krdarrah/trigBoard_docs/README.md

# trigBoard_docs
Documentation for trigBoard
