krdarrah/trigBoard_docs/docs/ePaperCoronaDisplay.rst

=======================
E-Paper Corona Display
=======================

.. raw:: html

    <div style="text-align: center; margin-bottom: 2em;">
    <iframe width="560" height="315" src="https://www.youtube.com/embed/fxBOs1GMj-A" frameborder="0" allow="accelerometer; autoplay; encrypted-media; gyroscope; picture-in-picture" allowfullscreen></iframe>
    </div>

This is a hard one to keep up to date, so make sure to check the `epaper Corona GIT page for latest <https://github.com/krdarrah/coronaDisplay_trigBoardEpaper>`_
