krdarrah/trigBoard_docs/docs/arduinoIoT.rst

.. _ArduinoIot:

=========================================
Arduino IoT Cloud - Temperature Monitor
=========================================

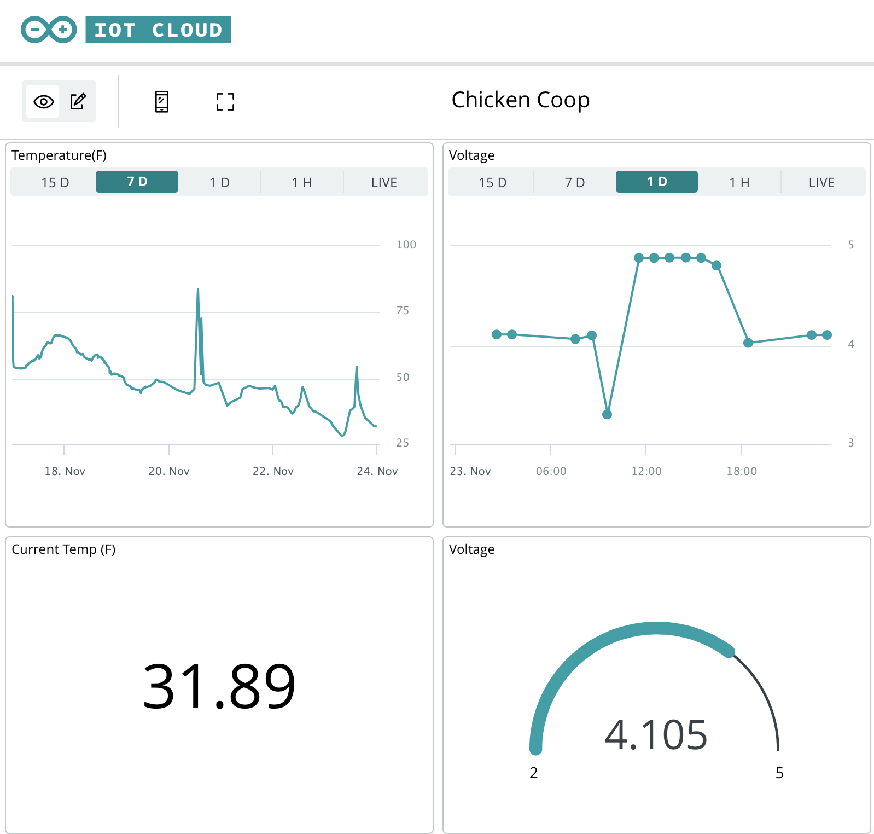
[picture p29: docs/images/arduinoIotDashboard.png]


Looking for a super easy and simple cloud service platform?  This might be a good fit for you!  There is also a free version to get you started, so that's a nice perk as well.

I was also happy to see they have a mobile app you can use to view your dashboards: 

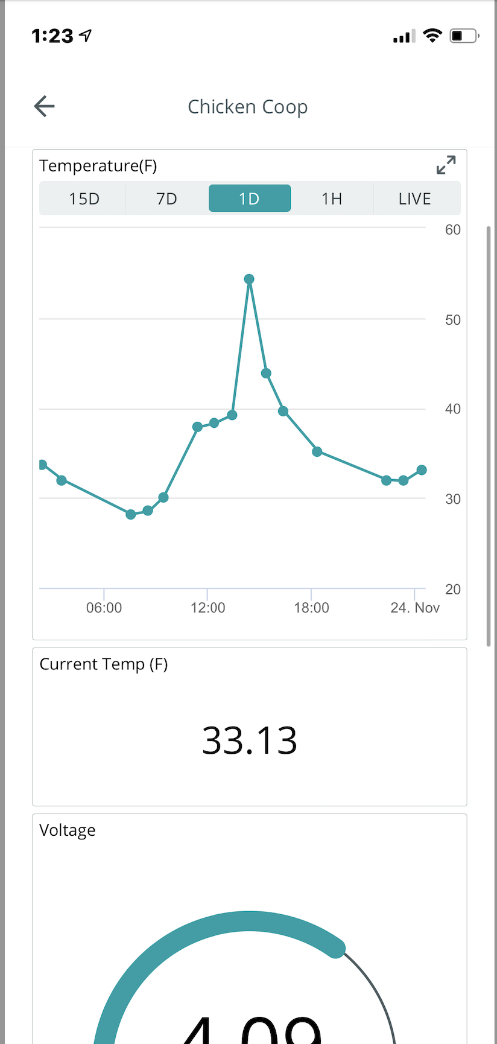
[picture p30: docs/images/mobilearduinocloud.png]


.. note::
	You can setup very easily with this using any ESP32 board, but this tutorial is specific to using the trigBoard and a temperature sensor.  Hopefully, this tutorial will show you how to set this up with any kind of sensor with the trigBoard (or no sensor at all - just contact status)

**Wiring**
-------------

You can use this without 

The wiring is simple - just need an `MCP9808 Breakout Board from Adafruit <https://www.adafruit.com/product/1782>`_ which is a very accurate, fast, and reliable temperature sensor.  Can also get these boards on Amazon for much cheaper.

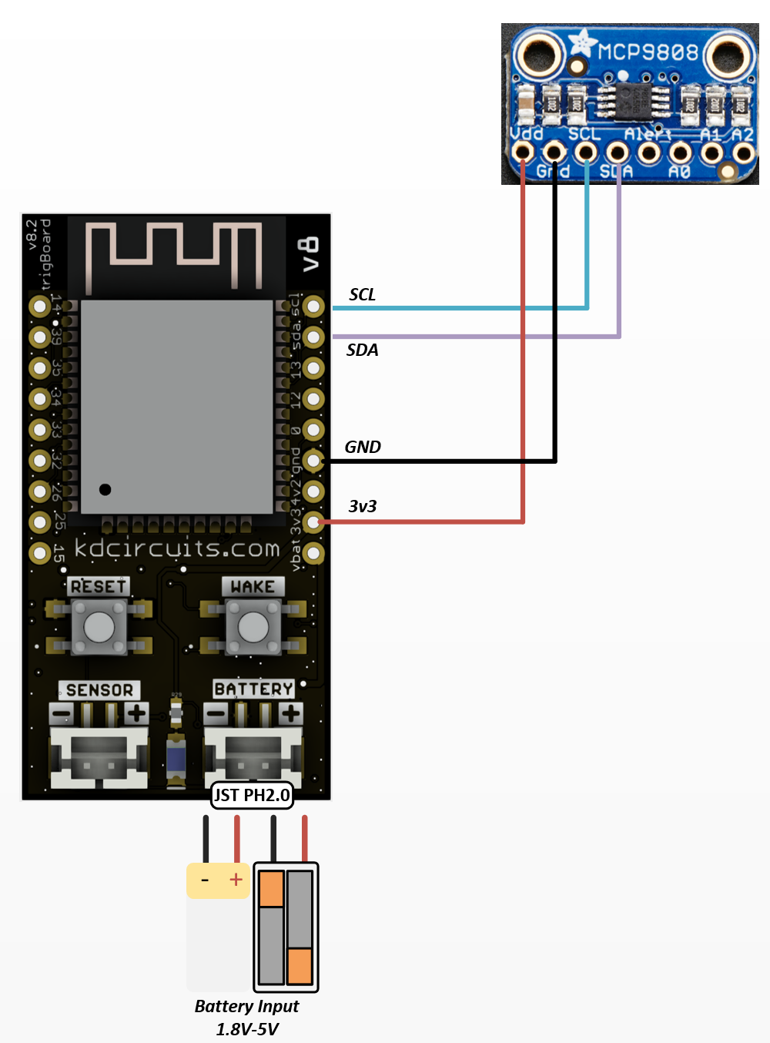
[picture p31: docs/images/MCP9808wiringwithtrigboard.png]


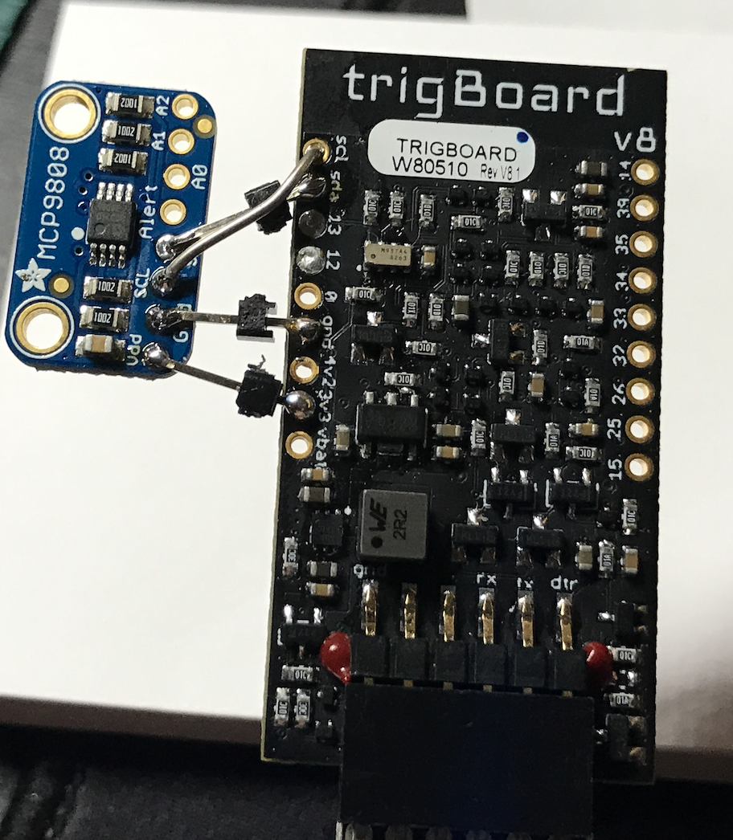
[picture p32: docs/images/MCP9808Installed.png]


Or even cleaner: 

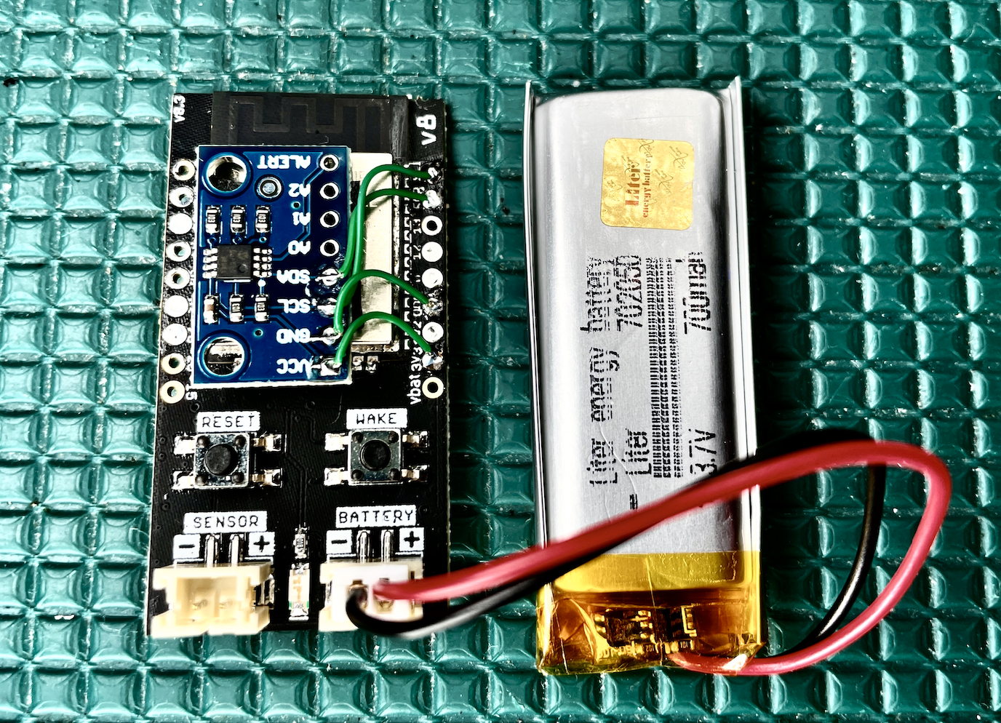
[picture p33: docs/images/mcp9808mountedtoshield.png]


**Arduino IoT Cloud Setup**
---------------------------------

First thing to do is login to your account at `Arduino IoT Cloud <https://create.arduino.cc/iot/>`_

Then let's just get started and create a device - will be a third party board: 

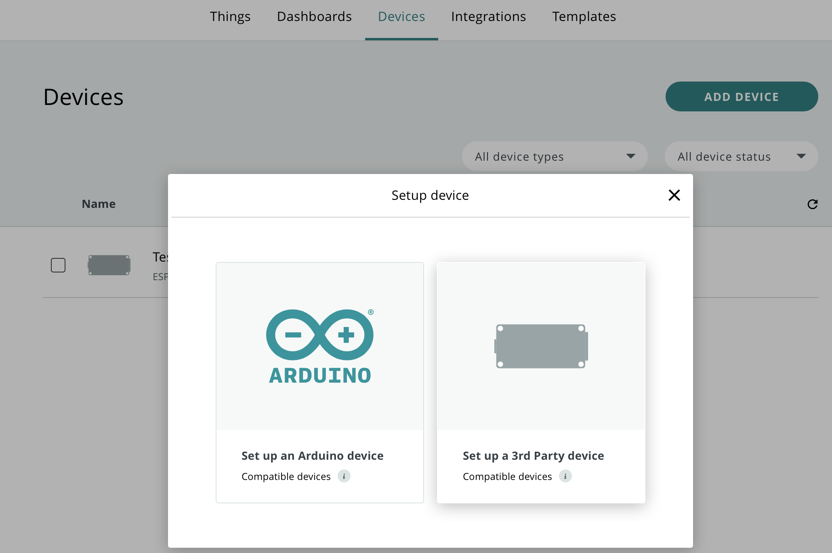
[picture p34: docs/images/thirdpartyboardarduino.png]


Will be ESP32, and select Dev Module: 

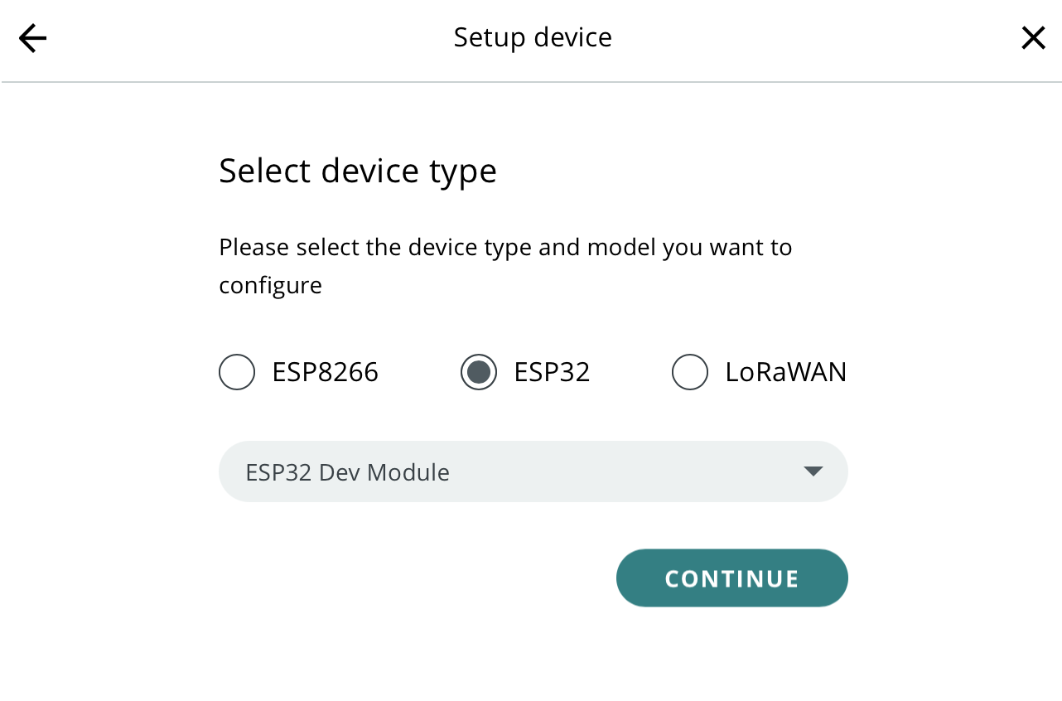
[picture p35: docs/images/devmoduleselectionArduino.png]


Give the board a name!

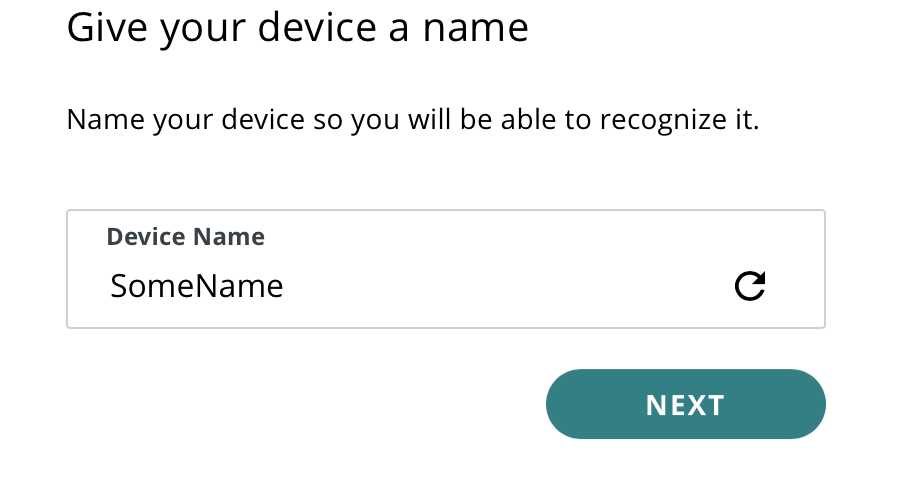
[picture p36: docs/images/giveanamearduino.png]


**Important** save the Device ID and Secret Key - we'll need these later

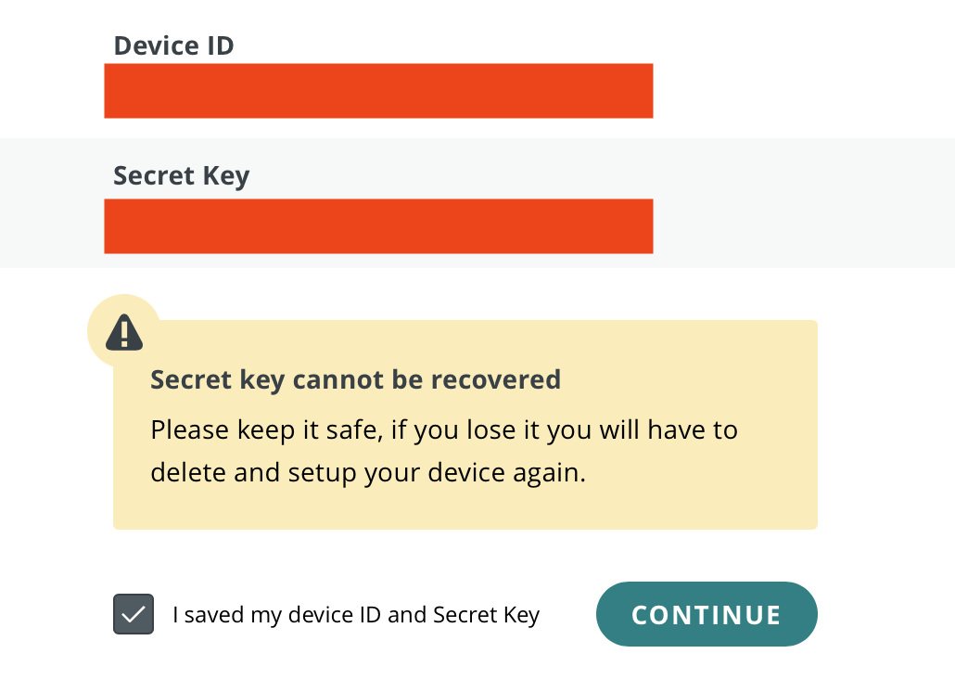
[picture p37: docs/images/deviceidsecretarduino.png]


Now we see the device is created and can create a thing with variables:

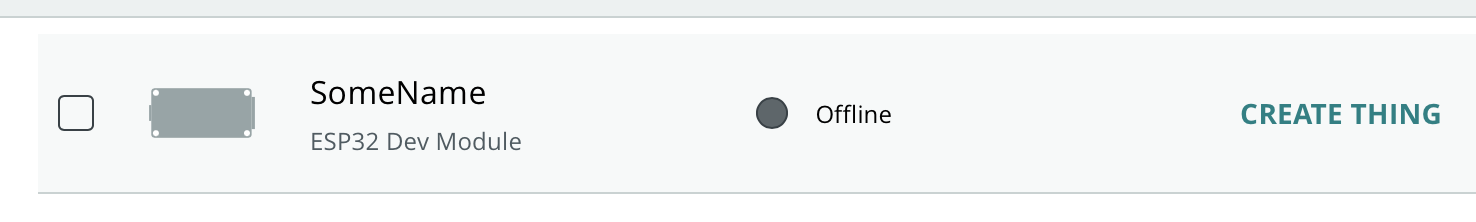
[picture p38: docs/images/createthingsarduino.png]


Then we create variables: 

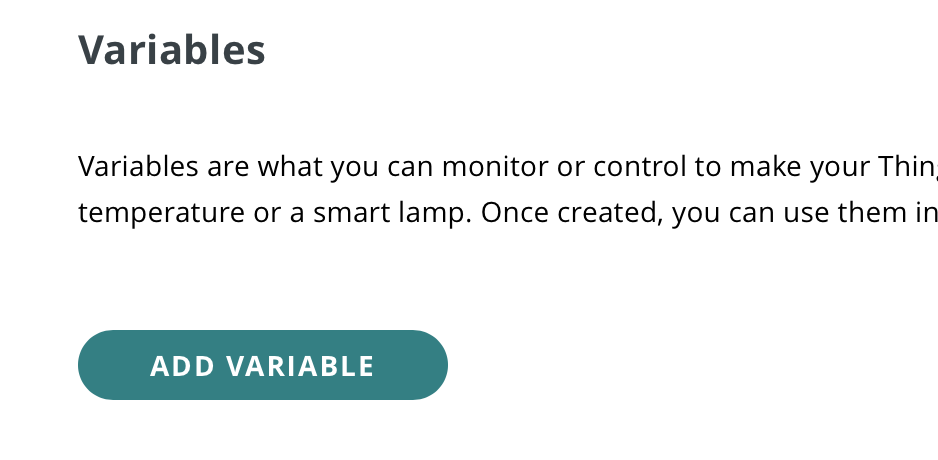
[picture p39: docs/images/createvariablesarduino.png]


For example, and as you'll see in the code, these variable names need to line up with the actual variable used in the trigBoard code: 

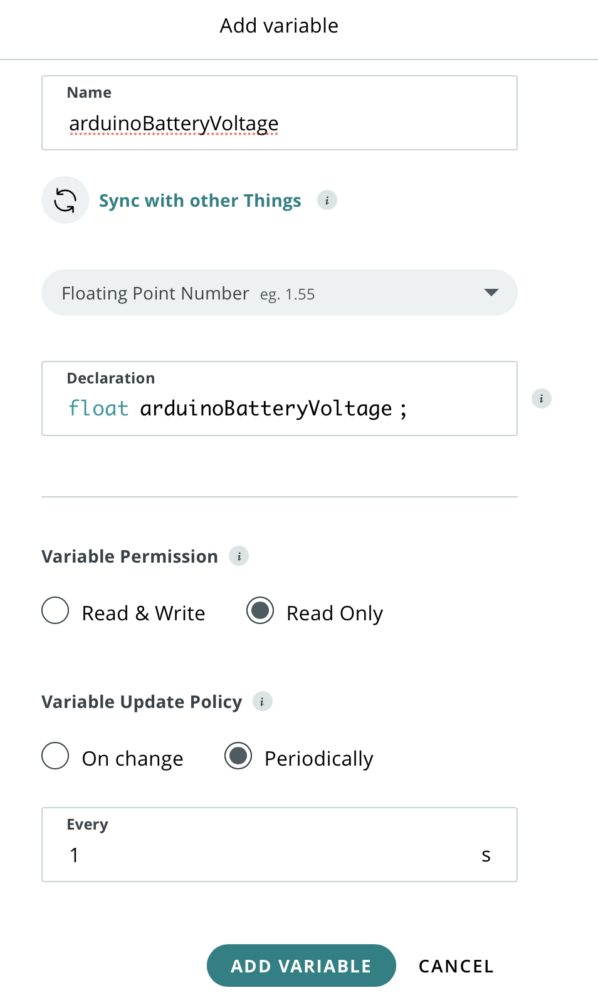
[picture p40: docs/images/variablesetupArduinoCloud.png]


The example code uses three variables - pay attention to type (float, bool, etc) and since we're just sending these up to the cloud, are read only and the periodic time doesn't matter.

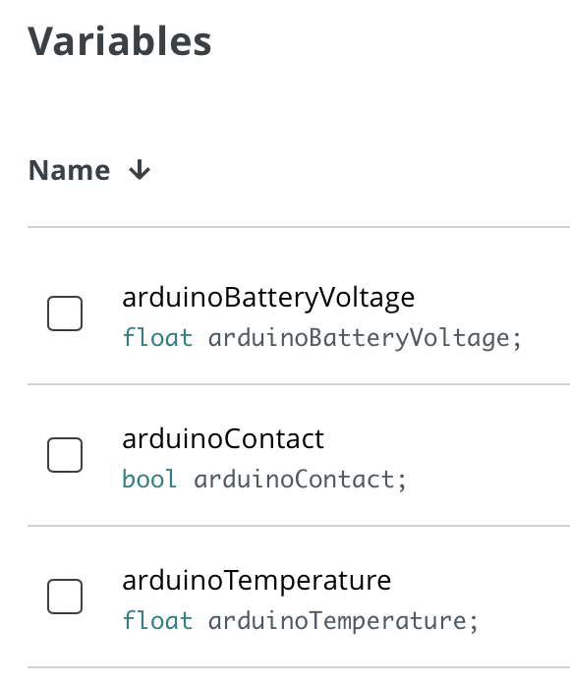
[picture p41: docs/images/threevariablesarduinocloud.png]


You have a Device ID, Secret Key, and now save the Thing ID at the bottom of this page - **You need all three**

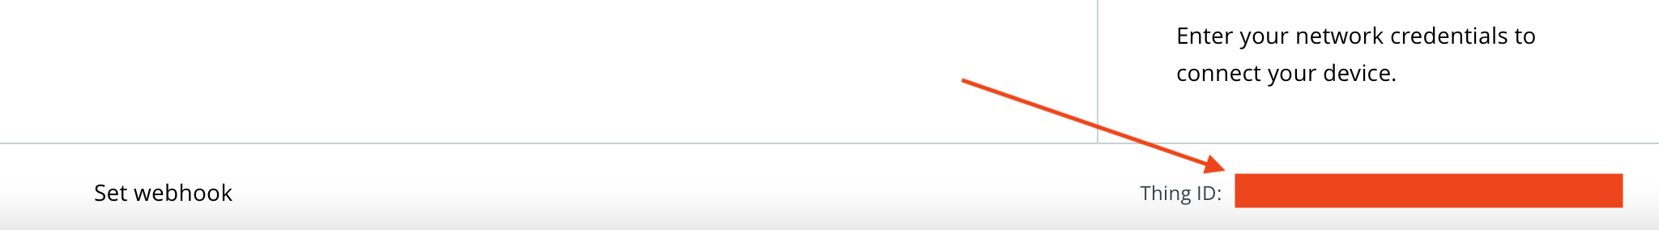
[picture p42: docs/images/thingIDarduinocloud.png]


From there, it's all pretty easy to create dashboards to visualize the data.  In the future, we'll look at how to pull this data out of the Arduino Cloud to automate things, like turn something on/off on a threshold.  

**trigBoard Setup**
---------------------------------

`The github repo is here <https://github.com/krdarrah/trigBoardV8_BaseFirmware_ArduinoIoT>`_

To compile this code as-is, you will need the MCP9808 library from Adafruit as well as the supporting libraries for Arduino IoT Cloud.  You can install all of these libraries from the Arduino IDE, you'll find it: sketch>>Include Library>>Manage Libraries  Note, you are still compiling the base firmware, so go to the :ref:`Firmware Page <Firmware>` for what is needed to do that

What's really cool about this code is that it re-uses other fields in the trigBoard configurator to set this up to work with Arduino IoT Cloud, so no need to hard code things. 

+------------------------------------+---------------------------+
|Configurator                        |Arduino IoT Cloud          |
+====================================+===========================+
|Pushover Key                        |Thing ID                   |
+------------------------------------+---------------------------+
|Pushover API Token/Key              |Device ID                  |
+------------------------------------+---------------------------+
|Push Safer Key                      |Secret Key                 |
+------------------------------------+---------------------------+
|Message when Wake Button Pressed    |C or F                     | 
+------------------------------------+---------------------------+

So then when you launch the configurator, you setup your WiFi credentials, the interval time in the timer settings, then the Arduino IoT Cloud parameters.

Taking a look at the code, you'll see how easy it is to modify variables - head over to the thingProperties.h tab: 

.. code-block:: C

	void initProperties() {

	  ArduinoCloud.setBoardId(config.pushAPIKey);
	  ArduinoCloud.setSecretDeviceKey(config.pushSaferKey);
	  ArduinoCloud.setThingId(config.pushUserKey);
	  ArduinoCloud.addProperty(arduinoTemperature, READ, 1 * SECONDS, NULL);
	  ArduinoCloud.addProperty(arduinoBatteryVoltage, READ, 1 * SECONDS, NULL);
	  ArduinoCloud.addProperty(arduinoContact, READ, 1 * SECONDS, NULL);

When you scroll down there, you can see how the ArduinoCloud properties are added.  These variables are declared as globals at the top of this file:

.. code-block:: C

	float arduinoTemperature;
	float arduinoBatteryVoltage;
	boolean arduinoContact;

From there, these variables are stuffed with the data we want to send up to the cloud: 

Head back over to the main tab, and you'll see how this is done: 

.. code-block:: C

	  arduinoTemperature = atof(temperatureString);
	  arduinoBatteryVoltage = getBattery();
	  arduinoContact = contactStatusClosed;//arduinoContact=true when contact closed
	  initProperties();//ArduinoIoTCloud
	  sendArduinoIoT();
