krdarrah/trigBoard_docs/docs/supportedServices.rst

.. _Services:

=======================
Supported Services
=======================

Where the notifications are sent - the :ref:`Configurator Tool <Configurator>` is used to enable and "configure" any of these.  If the notification needs to just go straight to your smart phone, then Pushsafer or Pushover would be a good start.  For more advanced users, UDP or MQTT can be used, but these require a central gateway (rapsberry Pi or host AP)

.. _Pushsafer:

Pushsafer
---------


| `Pushsafer Service <https://www.pushsafer.com>`_ is a great service for getting push notifications to your mobile devices. There are some nice features built in, like allowing for guest devices to be added/removed. This works nicely for a vacation setup where a someone may need to temporarily monitor a property. The notifications are purchased in bulk, but very inexpensive.
	
	**Pushsafer Setup**

	#. Go to `Pushsafer.com <https://www.pushsafer.com>`_ and create an account - you'll need to download/install the app as well
	#. Copy the private key:

		

	#. Paste that in the Configurator:

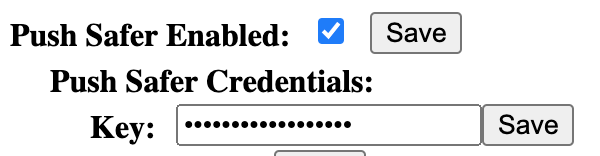
[picture p46: docs/images/pushsaferconfig.png]
		

.. _Pushover:

Pushover
---------


| `Pushover Service <https://pushover.net>`_ is similar to Pushsafer in that it's a good reliable service for getting push notifications to your devices when there's an event at the trigBoards.  The app is a one time purchase per device with a monthly allowance of 7500 notifications.  That should be plenty for most applications.

	**Pushover Setup**

	#. Go to `pushover.net <https://pushover.net>`_ and create and account - you'll need to download/install the app as well

	#. You should see your private user key:

		

	#. Scroll down and create a new application:

		

	#. Can leave things the way they are - name whatever you want:

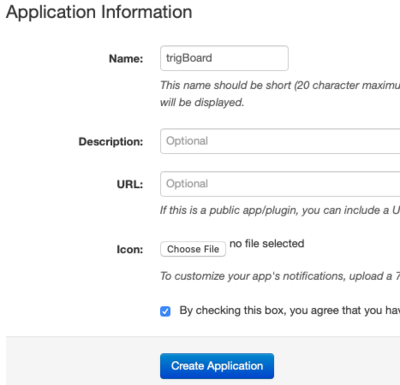
[picture p47: docs/images/400px-PushoverAppcreaet.png]
		

	#. Then you should see the API Token:

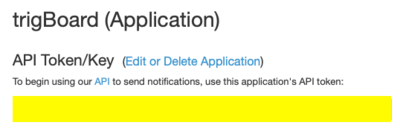
[picture p48: docs/images/400px-PushoverApitok.png]
		

	#. Paste both of those into the Configurator:

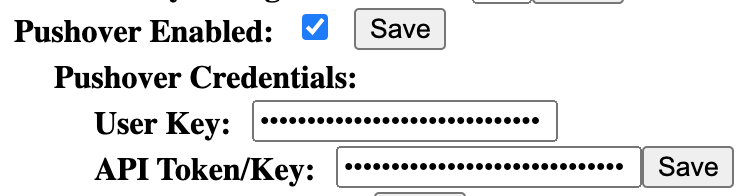
[picture p49: docs/images/pushoverConfig.png]
		

***********************
Sharing Notifications
***********************

If you want to share notifications with someone else, but not give them your login credentials, you can do that easily with Pushover.  Just note that if you ever plan on doing this, you should set this up ahead of time.  The user key will be different from the above steps, so you would have to change that on the trigBoard.  You would then be a subscriber to this feed yourself.

Follow the same steps as above to setup the application - in that screen, you can create a subscription code: 

		

Then fill out that screen and create new delivery group:

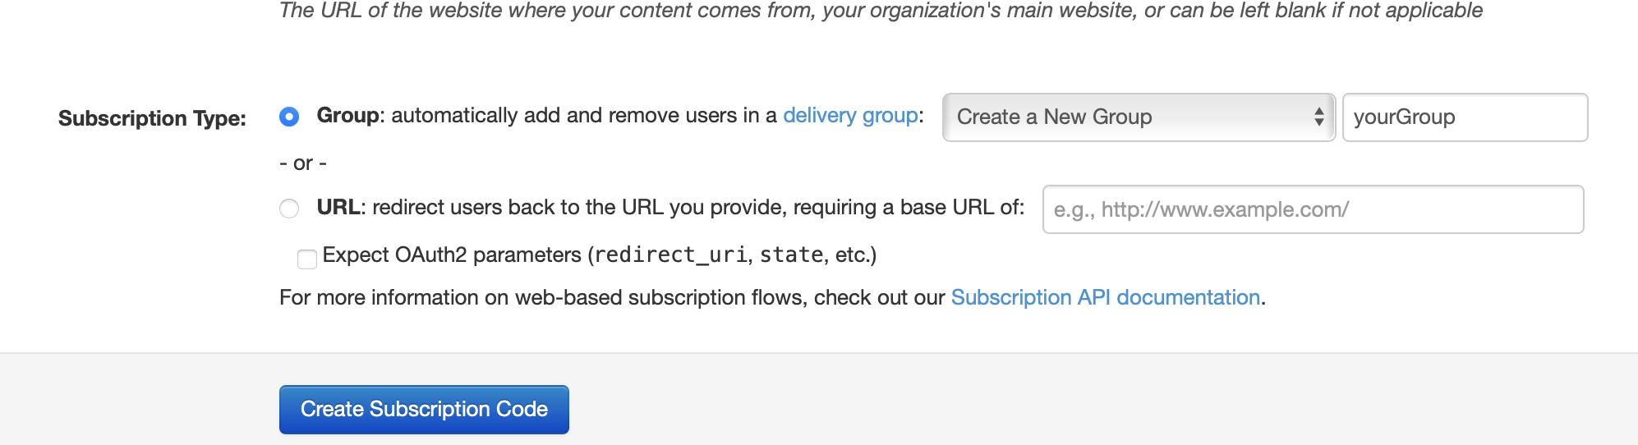
[picture p50: docs/images/deliverygroupcreate.png]
		

Then you'll notice in your application window, you have a new URL there that you can send people to subscribe to that feed:

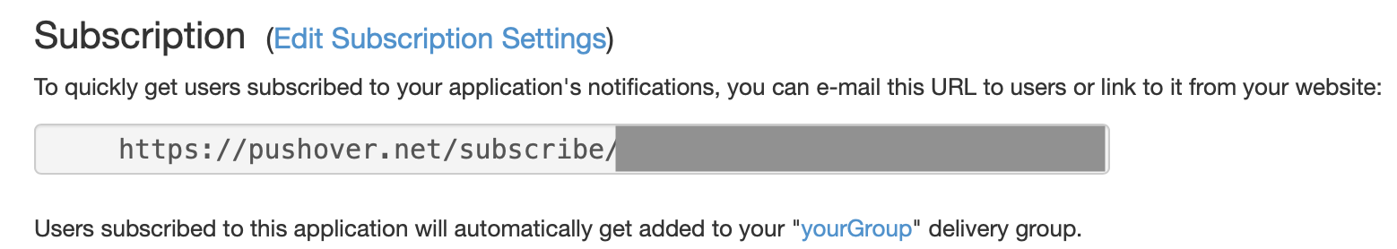
[picture p51: docs/images/suburlpushover.png]
		

But the thing about this is that the user key that you use for the configurator needs to be for this delivery group. To find this key, you can click below that URL - in this case the "yourGroup" link there:

		

There you will see the group key to be used as the user key in the trigBoard configurator - you still use the same API/Token Key from when you created the application:

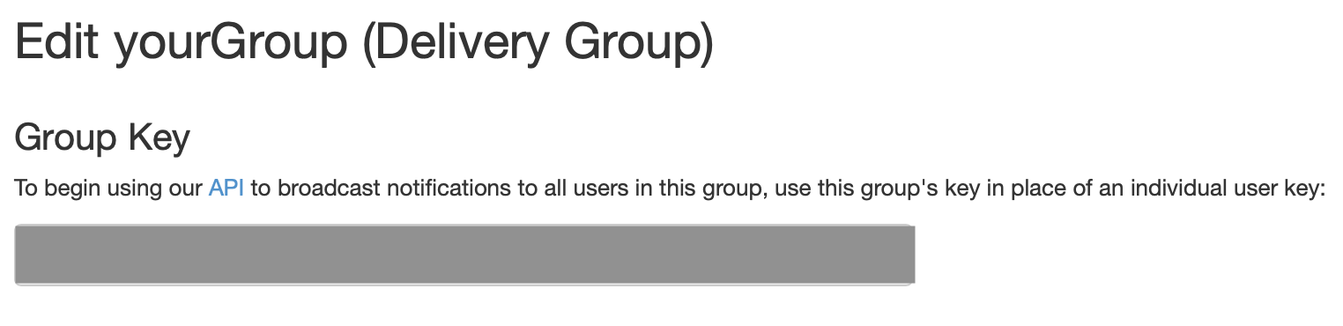
[picture p52: docs/images/groupkey.png]
		

And that's all there is to it!  

.. _IFTTT:

IFTTT
---------
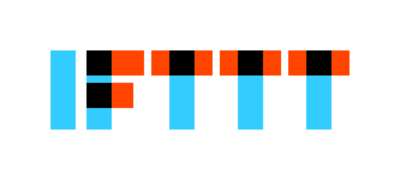
[picture p53: docs/images/400px-IFTTTlogo.png]


| This one is pretty obvious, but go check out the `IFTTT website <https://ifttt.com>`_ to see what all can be accomplished with this service. This alone can be used for the push notification, but it tends not be as fast as Pushsafer/Pushover. This is great for secondary alerts like sending emails, text messages, voice calls, home automation (lights on/off), publish to a google sheet, etc... there's a lot here

	**IFTTT Setup**

	#. Go to `IFTTT.com <https://ifttt.com>`_ which stands for "IF This Then That" and is a very powerful integration service that allows an event from the trigBoard to connect to other IoT services, like send an email, text, update a google spreadsheet, turn lights on/off, etc... It requires a maker key in order to work, so first sign up or sign in using whatever option you want to use. I use google to login.

	#. Search for webhooks, then click services:

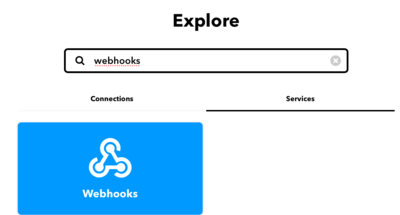
[picture p54: docs/images/400px-Iftttwebhooks.png]
		

	#. Just click on the webhooks service, click connect, and should be good to go. You should then see a "documentation" button:

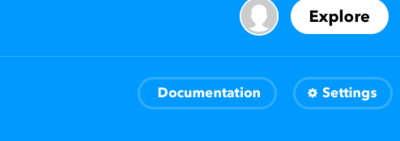
[picture p55: docs/images/400px-Iftttdocu.png]
		

	#. Here you will see the maker key:

		

	#. Then it's pretty easy to setup the IF this then That recipe. Just use the web hook for the IF event, where the Event Name is what is given as the trigBoard name in the configurator (no spaces), then the Value 1 is the name, Value 2 is the message.

	#. Paste that maker key into the configurator:

		

.. _Telegram:

Telegram
----------
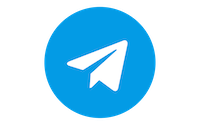
[picture p56: docs/images/Telegram-logo.png]


Added in base Firmware 8/16/21, and use  `Brian Lough's Library <https://github.com/witnessmenow/Universal-Arduino-Telegram-Bot>`_  This is a pretty cool way to send push notifications to all of your devices!  And it's free!

Here's a `good tutorial <https://randomnerdtutorials.com/telegram-control-esp32-esp8266-nodemcu-outputs/>`_ on getting the BOT Token and Chat ID - these two things are all that's needed

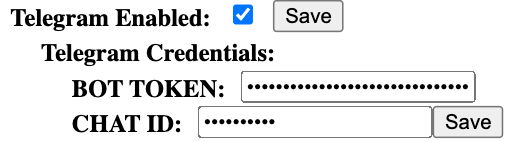
[picture p57: docs/images/telegramsettingsconfig.png]


UDP/TCP
---------

Note - TCP added to Firmware version 12/20/20 or newer.  These two options allow for a fully customized solution to whatever you might have in mind.  For example - see the :ref:`Cellular/Battery Backed System <CellularBattery>` project - this is a fully self contained system that relies on no outside services.  It's battery backed, hosts its own network, and can still send push notifications out fast.  This is just an example though - even a simple point to point system can be easily designed.  The trigBoard supports both UDP and TCP - `here's a good write-up <http://www.steves-internet-guide.com/tcp-vs-udp/>`_ on the differences.

To build your own gateway, here is some sample code you can use to run on an ESP32 to act as a server.  It supports both UDP and TCP: `Github Repo <https://github.com/krdarrah/trigBoard-Server-EXAMPLE-TCP-UDP>`_

Note - you will need to install the `ESPAsyncWebServer <https://github.com/me-no-dev/ESPAsyncWebServer>`_ and `AsyncTCP <https://github.com/me-no-dev/AsyncTCP>`_ Libraries

How it all works explained here: 

.. raw:: html

    <div style="text-align: center; margin-bottom: 2em;">
    <iframe width="560" height="315" src="https://www.youtube.com/embed/iNWH1FuM320" frameborder="0" allow="accelerometer; autoplay; encrypted-media; gyroscope; picture-in-picture" allowfullscreen></iframe>
    </div>

.. _UDP:

******
UDP
******

Because UDP is connectionless, the trigBoard configuration allows for a "blast", the default is to send out 10 packets separated by 10ms.  The idea is that this blast of packets guarantees at least one will get through.  There is no handshaking or acknowledgment back to the trigBoard, so it simply sends all of the packets and goes back to sleep.  This means the transmission will be faster, thus keeping the on-time shorter and conserving battery life.  Then again, without any knowledge that any of the packets got through, there's a chance they didn't.  

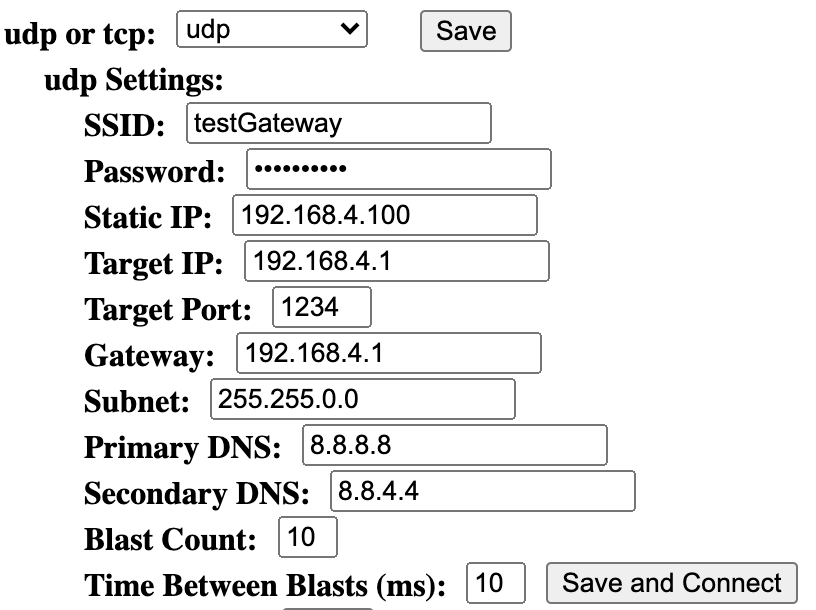
[picture p58: docs/images/udpsettings.png]
		

You can leave most of these settings to their default values.  Just set the SSID/PW, and if you're using the gateway as the access point, then that would default to 192.168.4.1, which is also the target IP.  Because connection speed is important here, select a static IP, which I normally use 192.168.4.100, 192.168.4.101, etc... `Here's a good subnet calculator <http://www.gregthatcher.com/Papers/IT/SubnetCalculator.aspx>`_

The message sent out is formatted like this: "<trigBoard Name> <Event>, <battery>" or as a real example: "test trigBoard 1 Contact Still Open-18-, 4.14V"

.. _TCP:

******
TCP
******

This was added in Firmware 12/20/20 - make sure you have the latest :ref:`Firmware Installed <Firmware>`

The inspiration for adding TCP messaging came from the need for an ultra reliable home security system.  The only downside here is that TCP may hurt battery life slightly since a full handshake between the trigBoards and receiving device occurs on every event.  Also, if the handshake fails, the trigBoard will attempt a number of retries.  

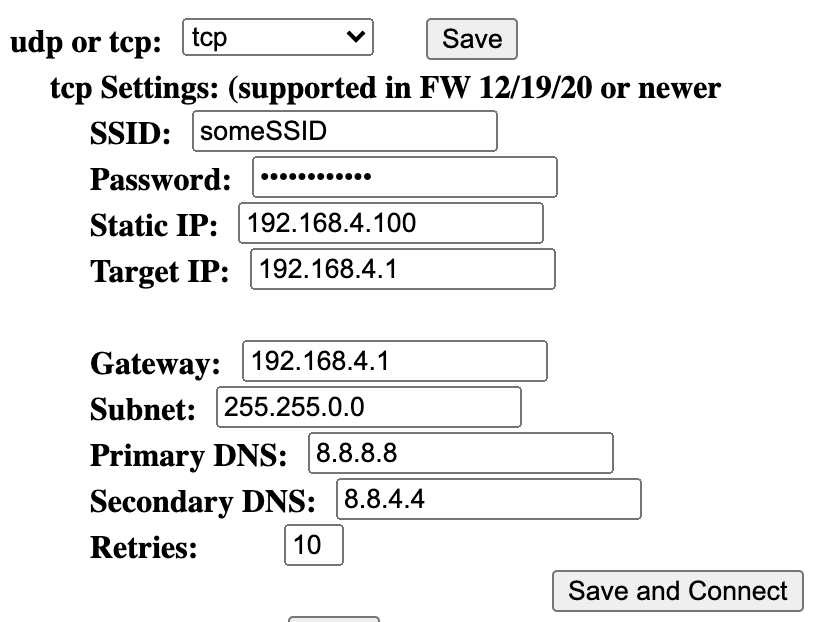
[picture p59: docs/images/tcpsettings.png]
		

The settings here are very similar to UDP, set the SSID/PW for the gateway and set target IP and static IP.  Note that the port is fixed to 80.  The retries value is how many full attempts the trigBoard will make before going back to sleep.  This actually reconnects to the SSID, so be careful setting the WiFi Timeout value above - may want to lower this in case you loose the gateway or make a mistake in here and the board cannot connect.  That means that to re-enter the configurator mode, you will have to wait for all failure attempts.  So if WiFi timeout is 10seconds, and retries is 10, then you'll need too wait for 100seconds.  This of course is only if it can't connect.

The message sent out is formatted like this: "<trigBoard Name> <Event>, <battery>$$$<timestamp>" or as a real example: "test trigBoard 1 Contact Still Open-18-, 4.15V$$$34743"   the reason for the unique timestamp there is just in case the gateway receives the message, but then a retry is attempted.  So that means that the acknowledgment back to the trigBoard failed and it attempted the retry.  The gateway will see the same message and know that the trigBoard is just trying again, not that it's a unique event from that same trigBoard, which would be like the front door opening and closing twice quickly.  

.. _MQTT:

MQTT
---------

Similar to UDP, but if you're using the raspberry pi or something to run your home automation system, and it's all based on MQTT messaging, then this will work great for that. This also works great with :ref:`Home Assistant <HomeAssistant>`
