krdarrah/trigBoard_docs/docs/LogGoogleDocs.rst

.. _googleDocs:

=============================
Log to Google Sheet - IFTTT
=============================

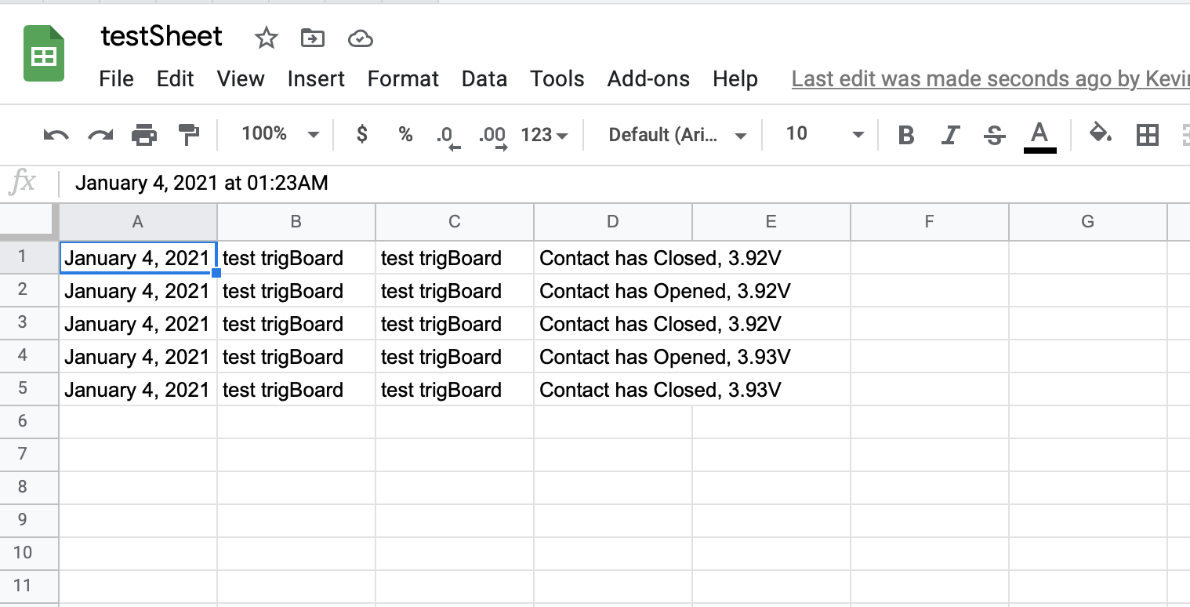
[picture p205: docs/images/testsheetgoogle.png]


**Log trigBoard events to an online Google Sheet!**  This is very simple with IFTTT, but you will need to obtain a free maker key - go to the :ref:`Supported Services Page <IFTTT>` to set this up.  Once you have the key, you can proceed with the following steps.  Also note that you can use this as a "backup", so receive a push notification as well as an email.  Just enable any service you want and they'll all fire off at once.  

**Create an Applet**

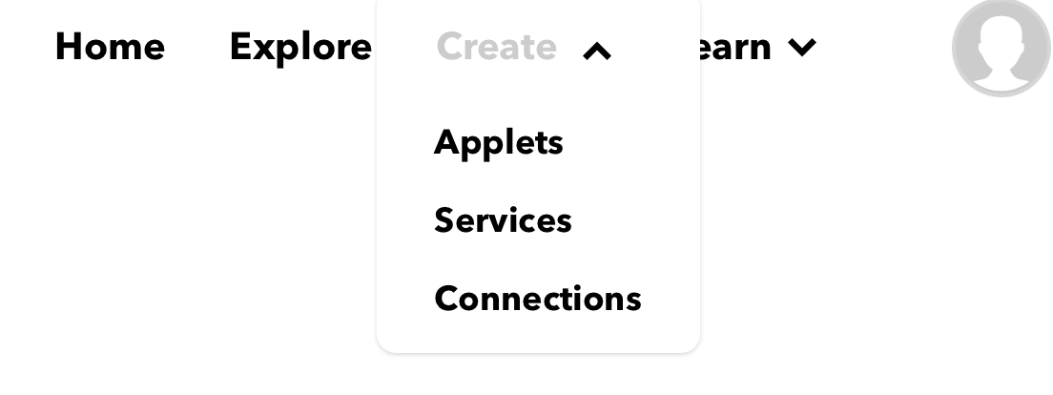
[picture p206: docs/images/createApplet.png]


**Click Add**

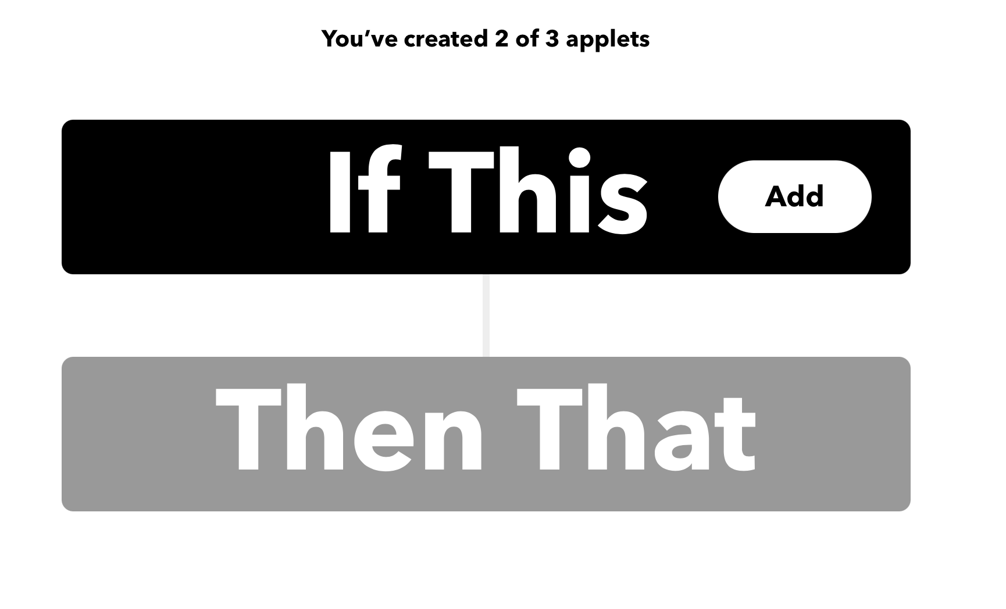
[picture p207: docs/images/ifbuttonclick.png]


**Search for Webhooks**

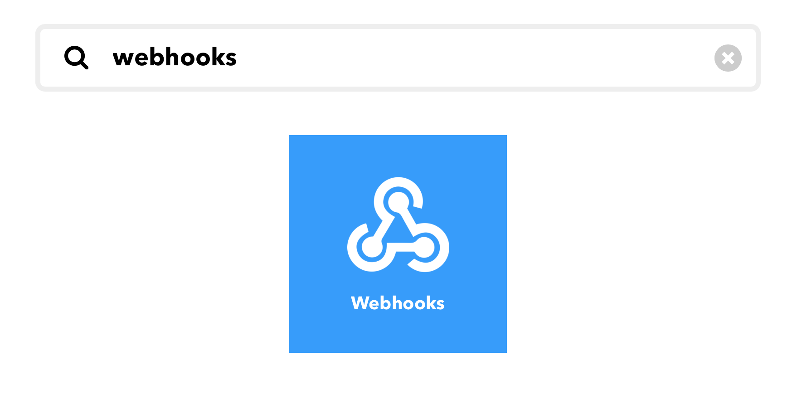
[picture p208: docs/images/searchforwebhooks.png]


**Select this**

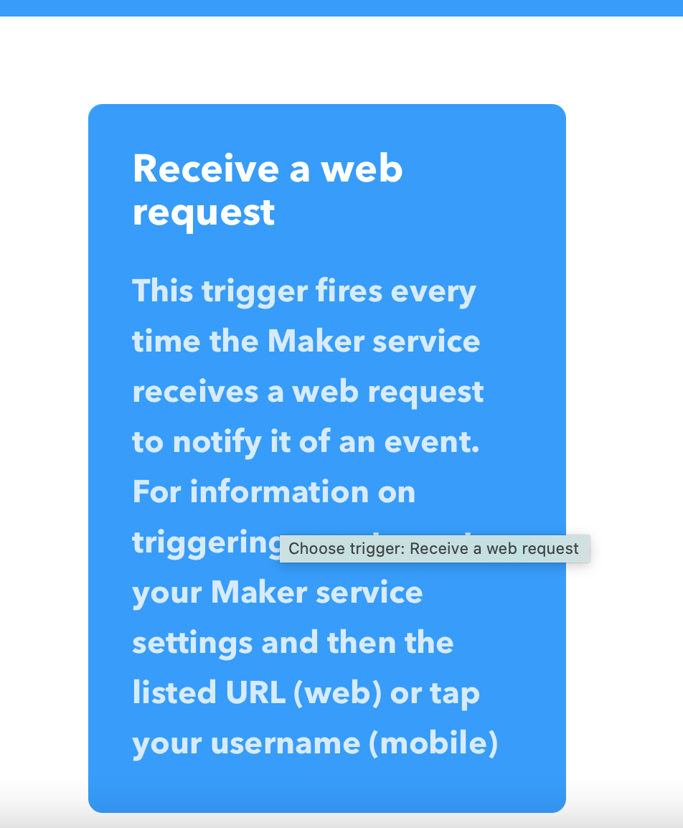
[picture p209: docs/images/selectwebhooks.png]


**This is important - the Event Name must Match the trigBoard Name you give in the Configurator**

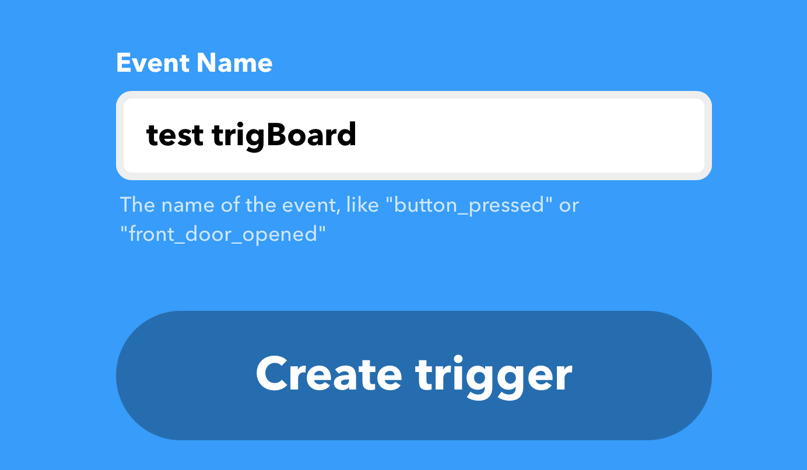
[picture p210: docs/images/eventNameapplet.png]


**"THAT" click Add**

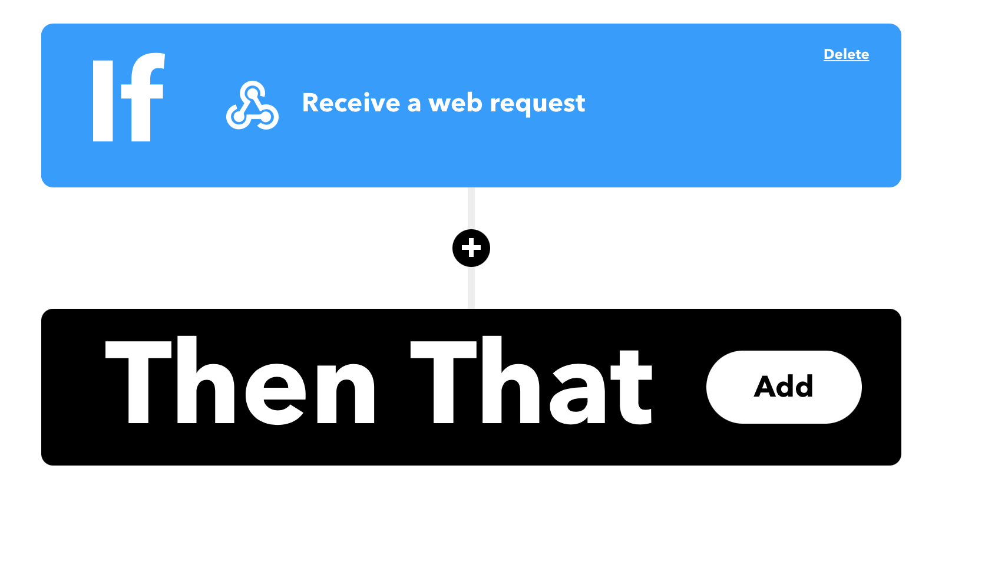
[picture p211: docs/images/thatbuttponclick.png]


**Search Google Sheets and select add row - note that you will have to link this to your google account**

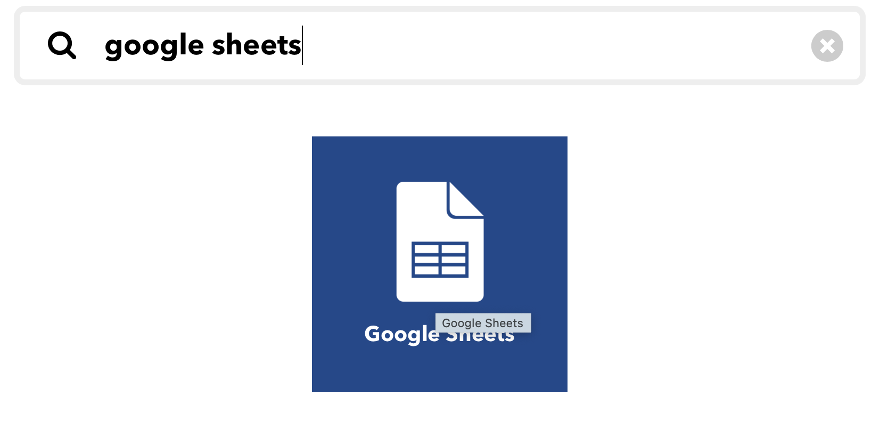
[picture p212: docs/images/googlesheetsearchsheet.png]


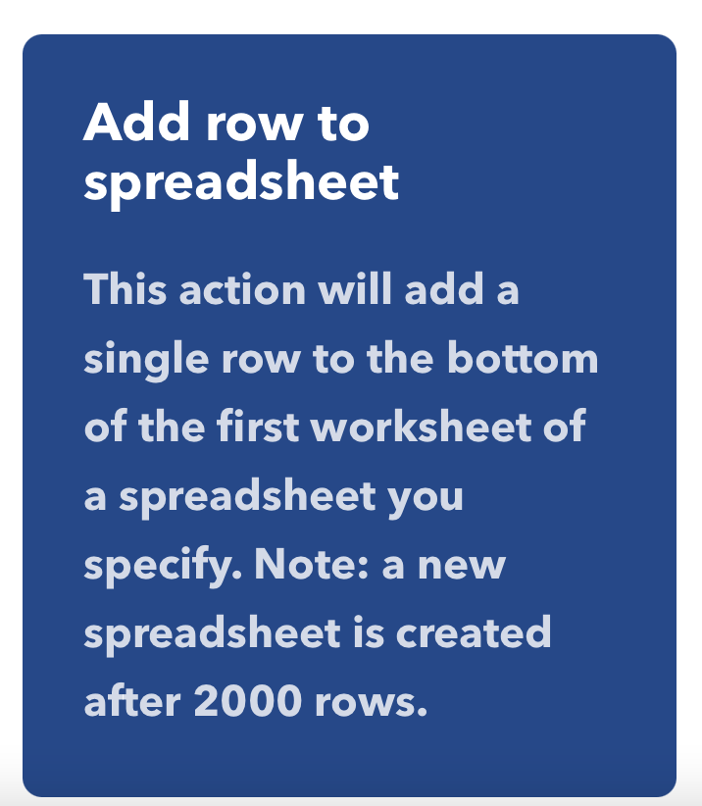
[picture p213: docs/images/googleaddrowsheet.png]


**The settings for the spreadsheet - give the sheet a name and note that Value3 is not used, so can delete that**

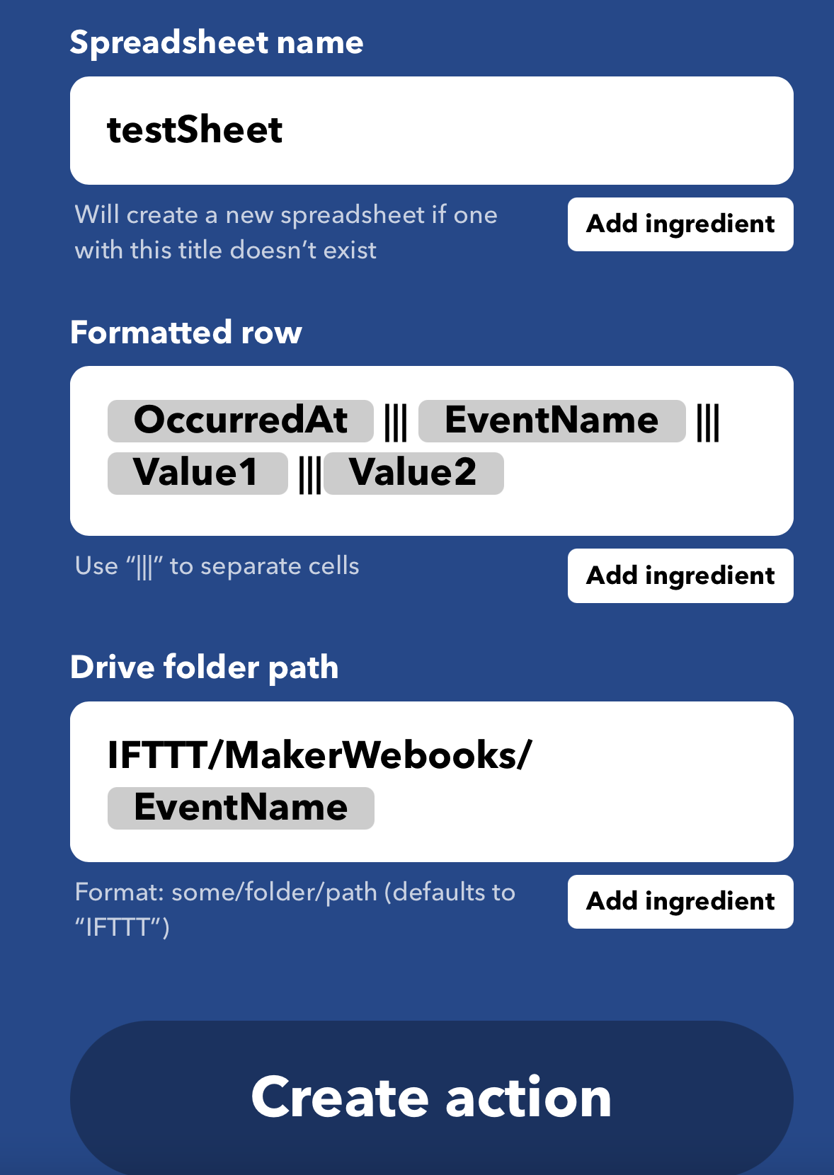
[picture p214: docs/images/googlesheetappletsettings.png]


**All set then - continue**

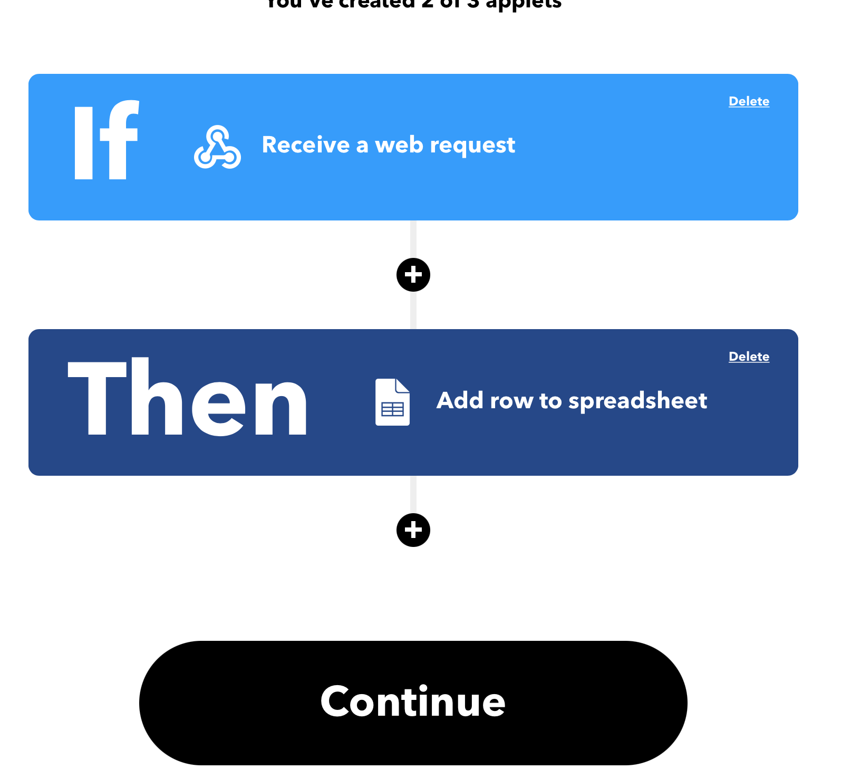
[picture p215: docs/images/googlesheetappdone.png]


**Give the applet a custom name and finish up**

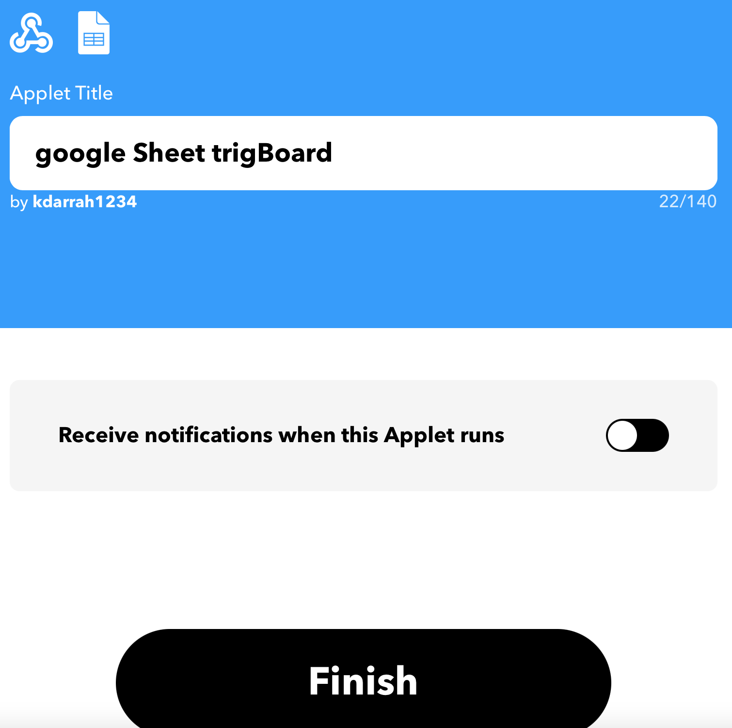
[picture p216: docs/images/googlesheetapplname.png]


**Launch the Configurator and set things up, WiFi, IFTTT enabled and put your Maker Key in, and set the trigBoard name to the Event Name**

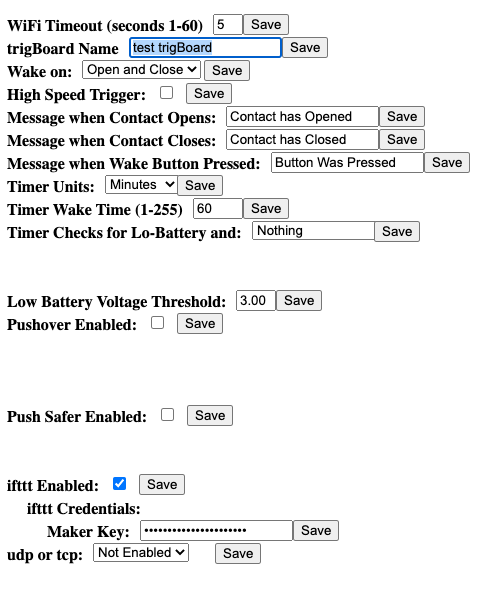
[picture p217: docs/images/configuratoriftttname.png]


**All set! Now you can test things out and you should see a spreadsheet**

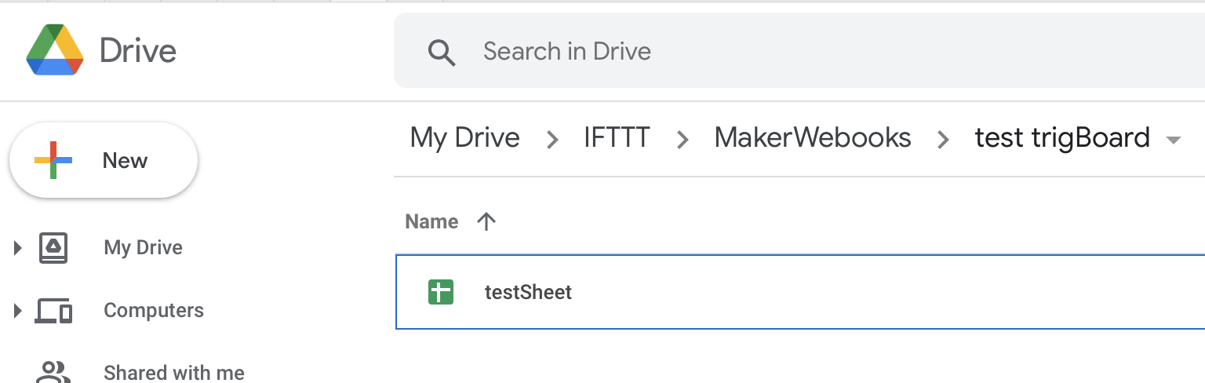
[picture p218: docs/images/googledrivefile.png]


.. warning::
	I have seen some issues here where the spreadsheet is not automatically created... in that case, try creating it manually per the path you have configured in the settings for this applet. If still having problems, you can disconnect the link with Google from IFTTT and try re-creating the applet.  

**And after testing a couple events, all looks good! Note that you can go back into the settings for this applet and modify how the logs are added.  Also, multiple trigBoards can log to the same sheet, just add a prefix to the contact open/close message while using the same trigBoard name. So name might be trigBoard, then contact open message " Garage Opened" and second trigBoard using same name could have its message " Front Door Opened"**
