krdarrah/trigBoard_docs/docs/contact.rst

.. _Contact:

===========================
Contact
===========================

If any questions or business inquiries, please `contact KD Circuits directly <https://www.kdcircuits.com#contact>`_

I also created a Discord, so if you did not get invited yet to it, send me an email and I'll get you the link.  All active development and collaboration is discussed there.

All active development discussed up here:

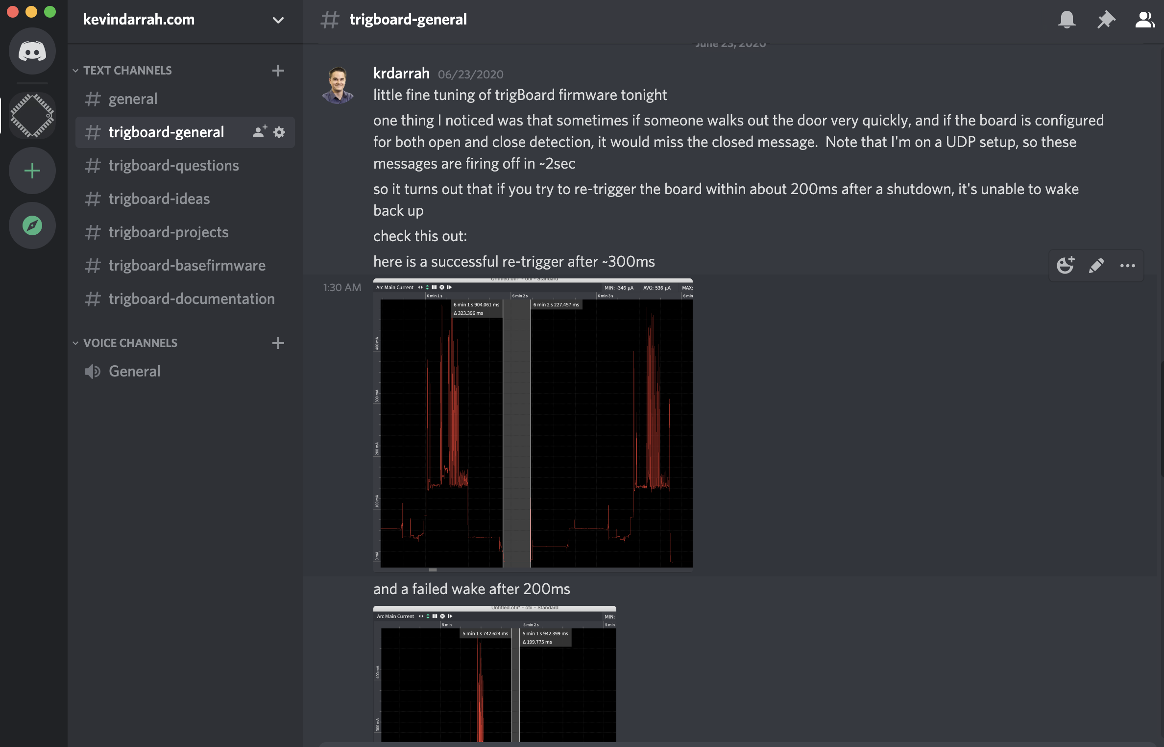
[picture p226: docs/images/discord.png]
