krdarrah/trigBoard_docs/docs/wheretobuy.rst

=======================
Where To Buy
=======================

The best place to purchase the trigBoard and accessories is through the `Tindie Store <https://www.tindie.com/stores/kdcircuits/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>`_

.. raw:: html

	<div>
	
	</div>

For higher quantities or OEM opportunities, please `contact KD Circuits directly <https://www.kdcircuits.com#contact>`_
