krdarrah/trigBoard_docs/docs/images/adafruitJson.png

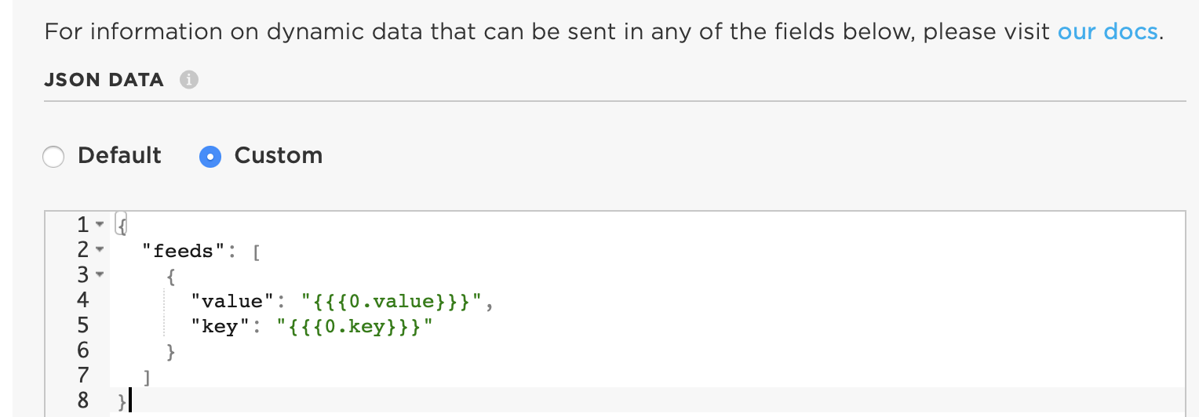
docs/images/adafruitJson.png
