krdarrah/trigBoard_docs/docs/images/boardsettingscondfi.png

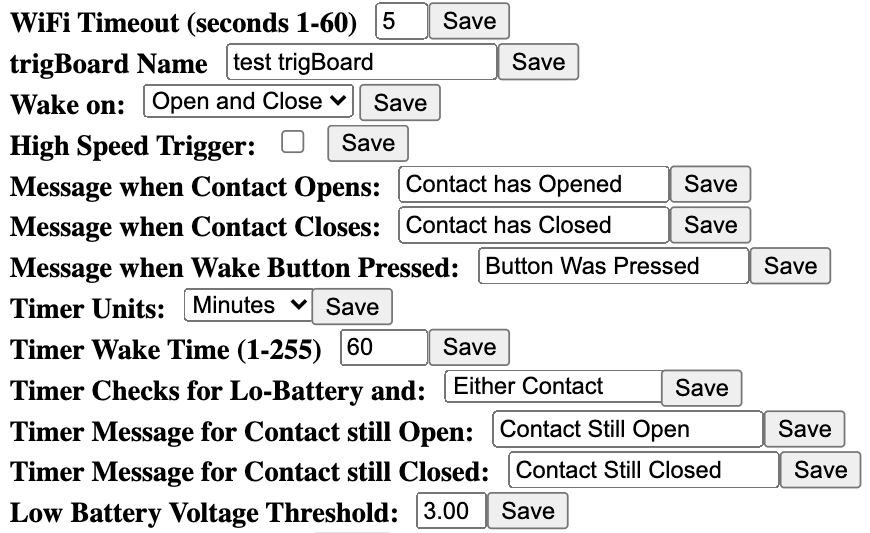
docs/images/boardsettingscondfi.png
