krdarrah/trigBoard_docs/docs/images/ESP32-WROOM.jpg

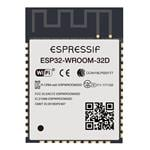
docs/images/ESP32-WROOM.jpg
