krdarrah/trigBoard_docs/docs/images/garagegif.gif

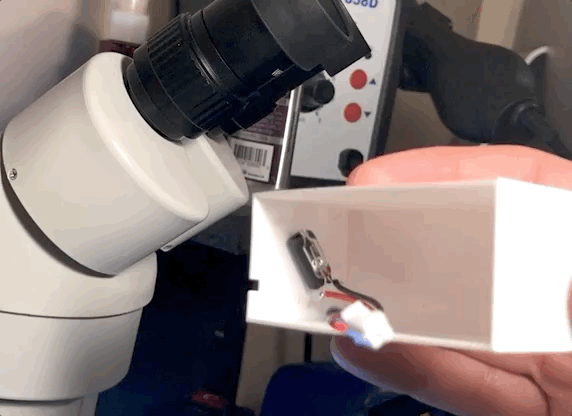
docs/images/garagegif.gif
