krdarrah/trigBoard_docs/docs/images/mercgaragebuttoned.png

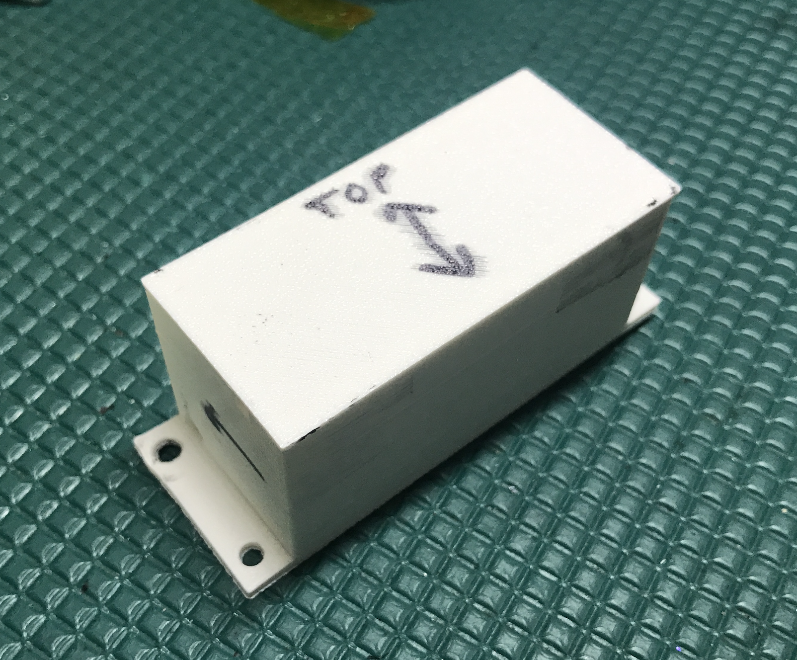
docs/images/mercgaragebuttoned.png
