krdarrah/trigBoard_docs/docs/images/mercmountedenc.png

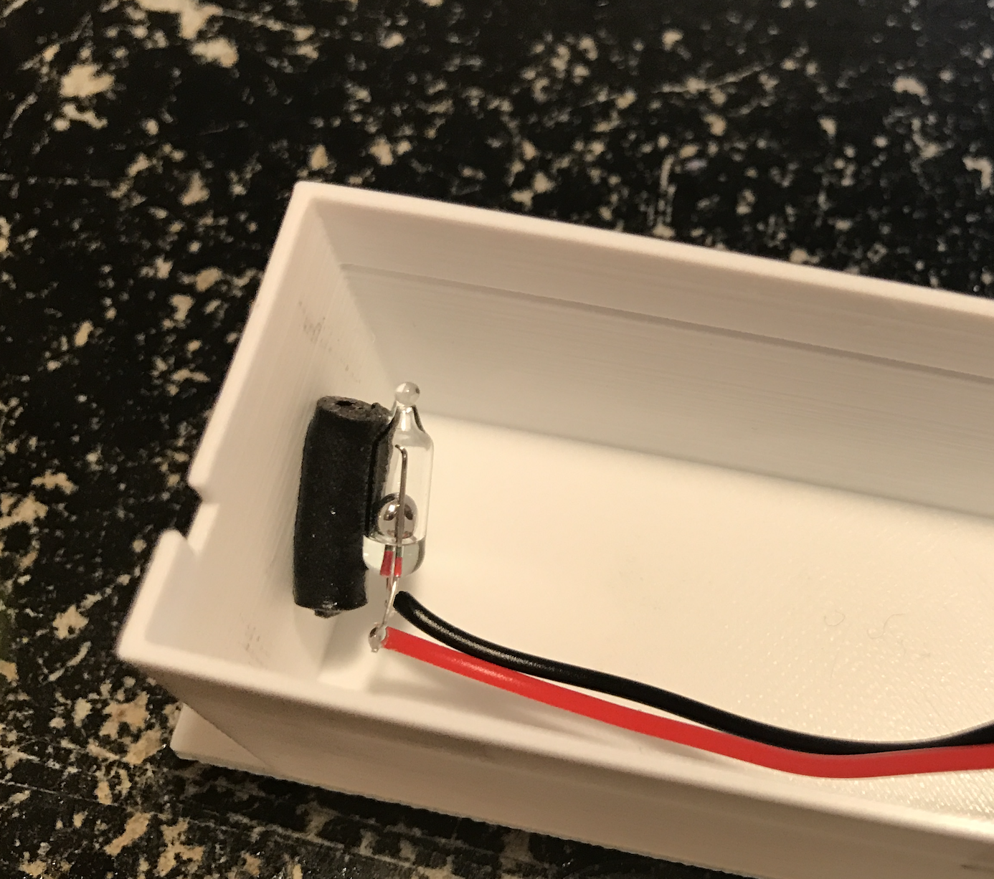
docs/images/mercmountedenc.png
