krdarrah/trigBoard_docs/docs/images/mercmountedongarage.png

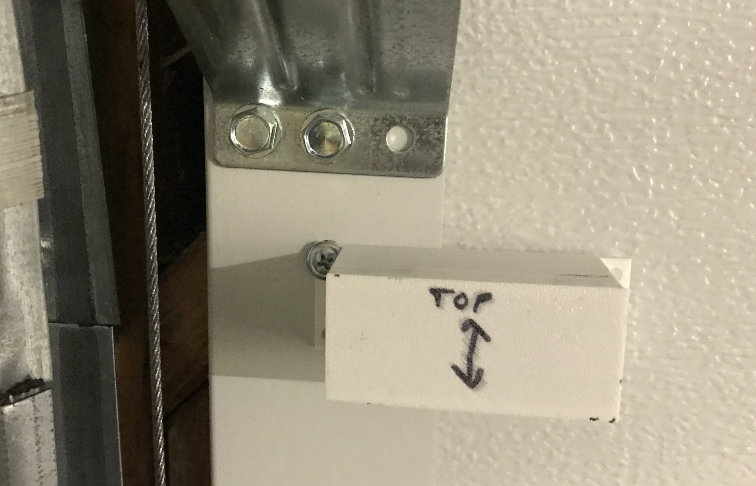
docs/images/mercmountedongarage.png
