krdarrah/trigBoard_docs/docs/images/mercswitchebay.png

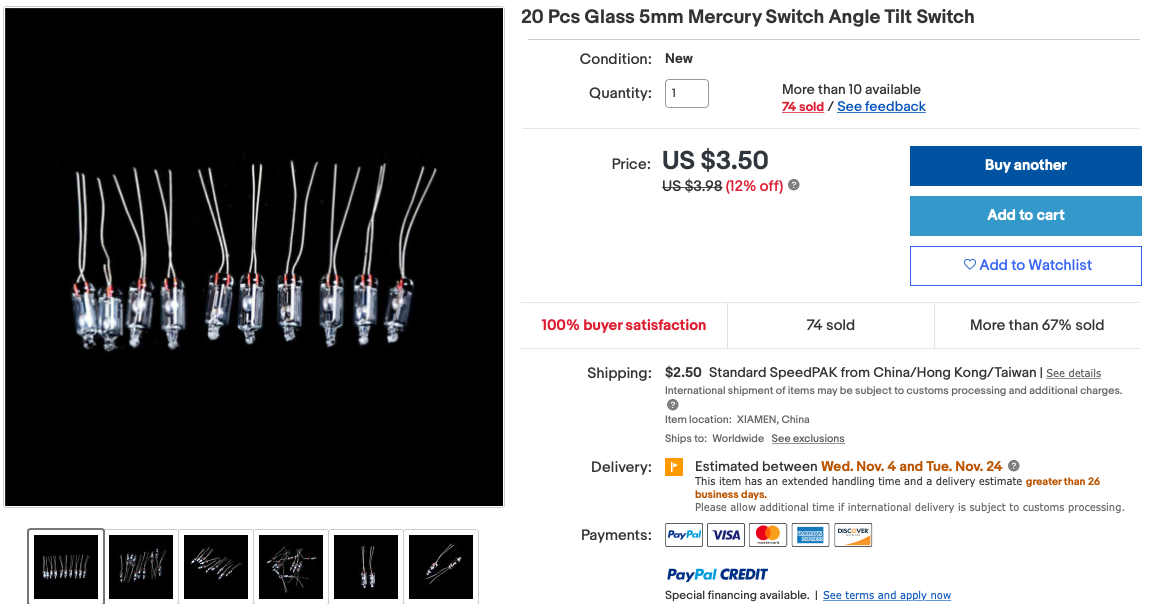
docs/images/mercswitchebay.png
