krdarrah/trigBoard_docs/docs/images/rtvaplied.png

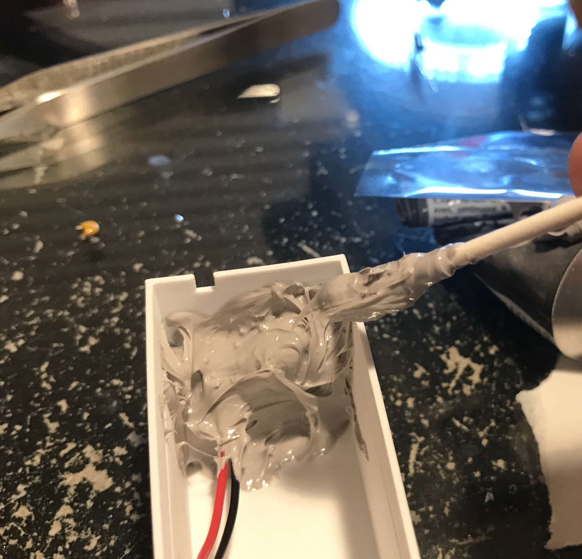
docs/images/rtvaplied.png
