krdarrah/trigBoard_docs/docs/images/RTVstuff.png

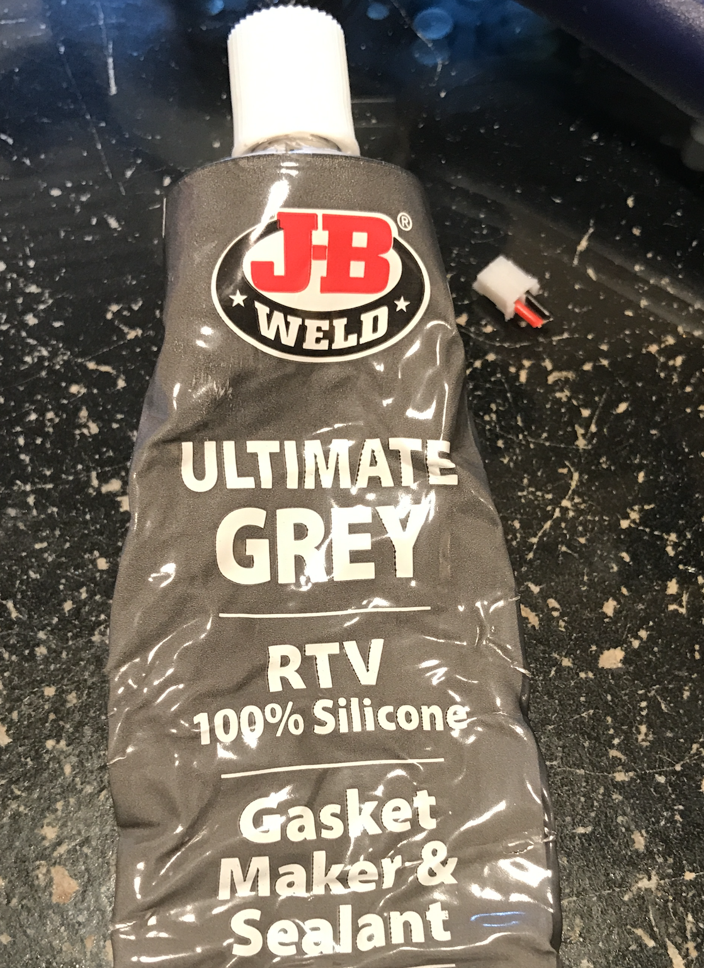
docs/images/RTVstuff.png
