krdarrah/trigBoard_docs/docs/images/Screen_Shot_2020-05-15_at_10.09.37_PM.png

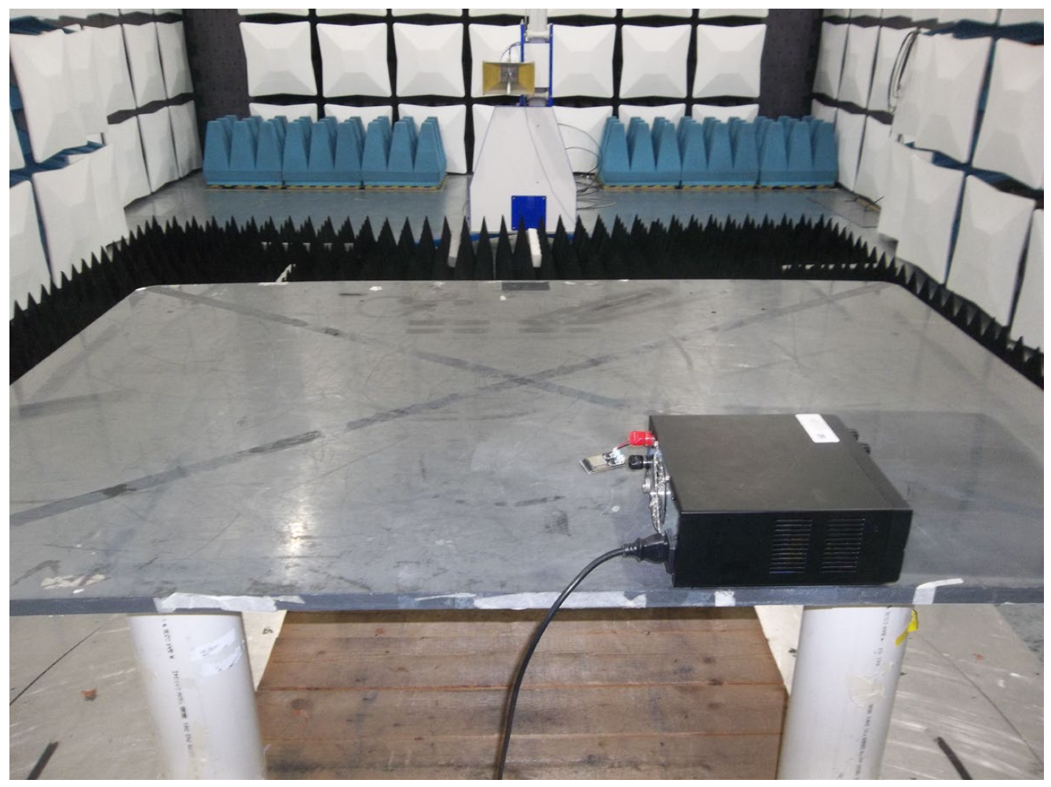
docs/images/Screen_Shot_2020-05-15_at_10.09.37_PM.png
