krdarrah/trigBoard_docs/docs/images/smokeCOdiagrma.png

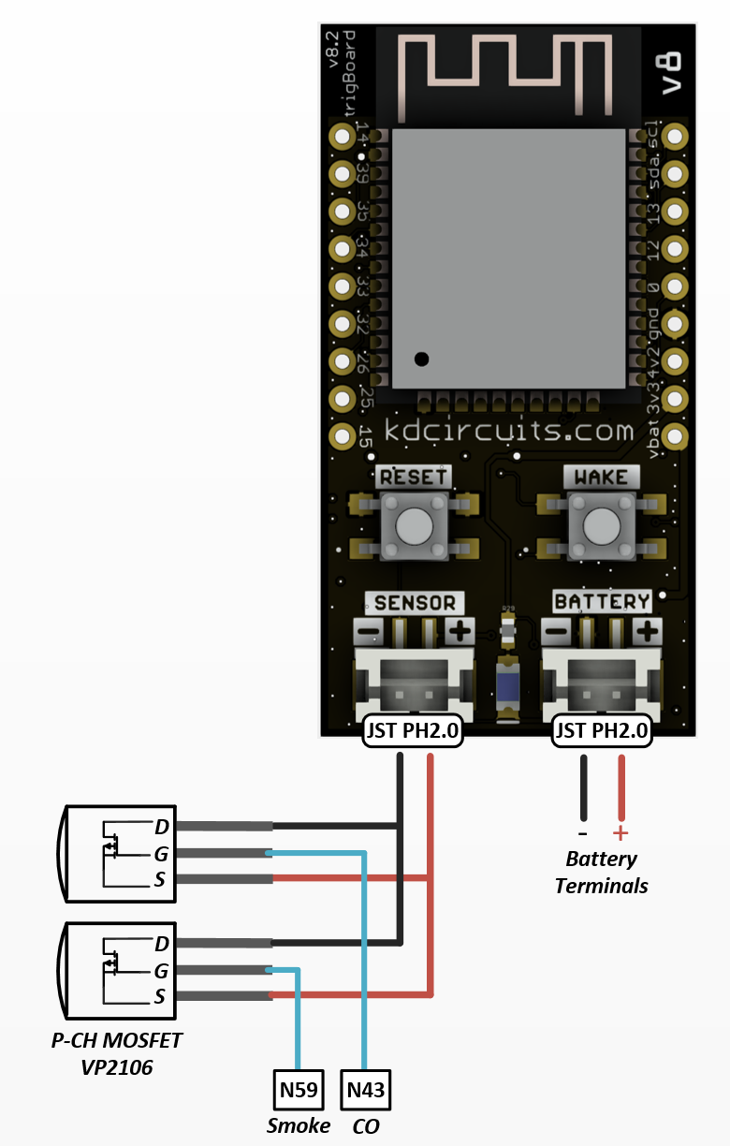
docs/images/smokeCOdiagrma.png
