krdarrah/trigBoard_docs/docs/images/TCPtransmission240MHz.png

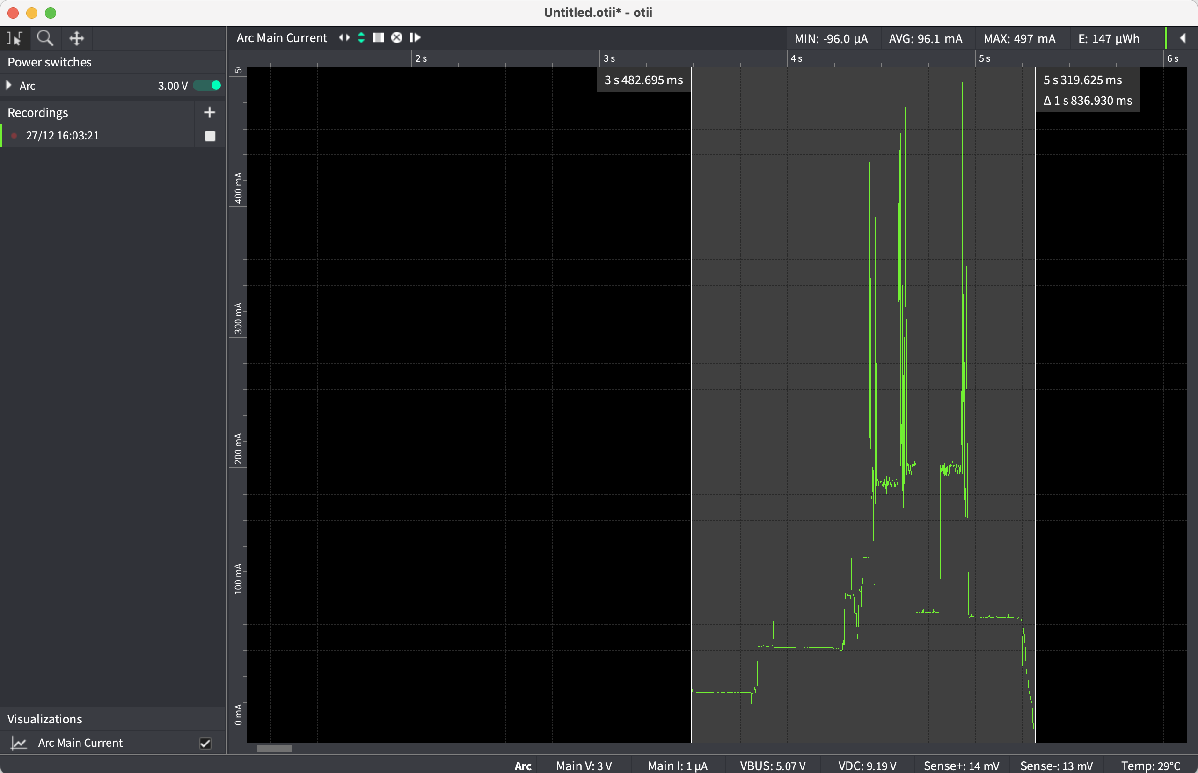
docs/images/TCPtransmission240MHz.png
