krdarrah/trigBoard_docs/docs/images/trigBoardFeat.png

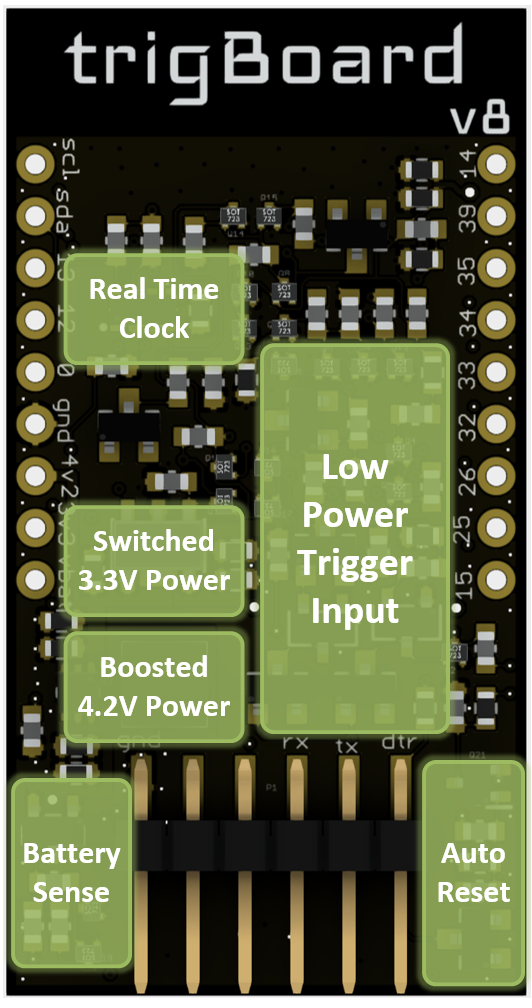
docs/images/trigBoardFeat.png
