krdarrah/trigBoard_docs/docs/images/V8Pinout.png

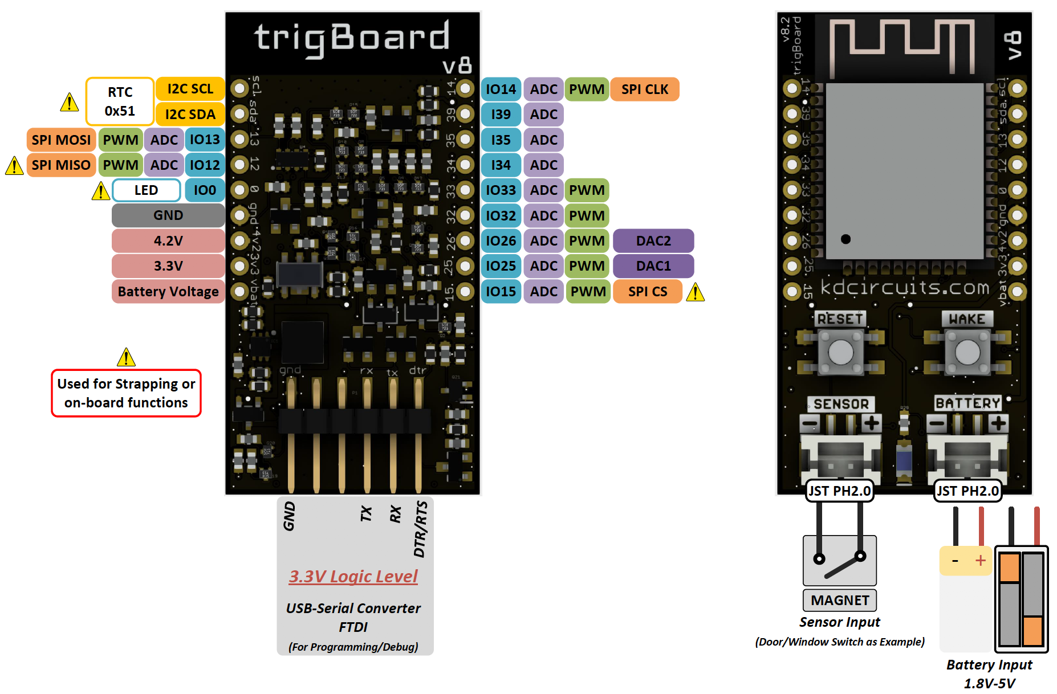
docs/images/V8Pinout.png
