krdarrah/trigBoard_docs/docs/images/variablesarduinocloud.png

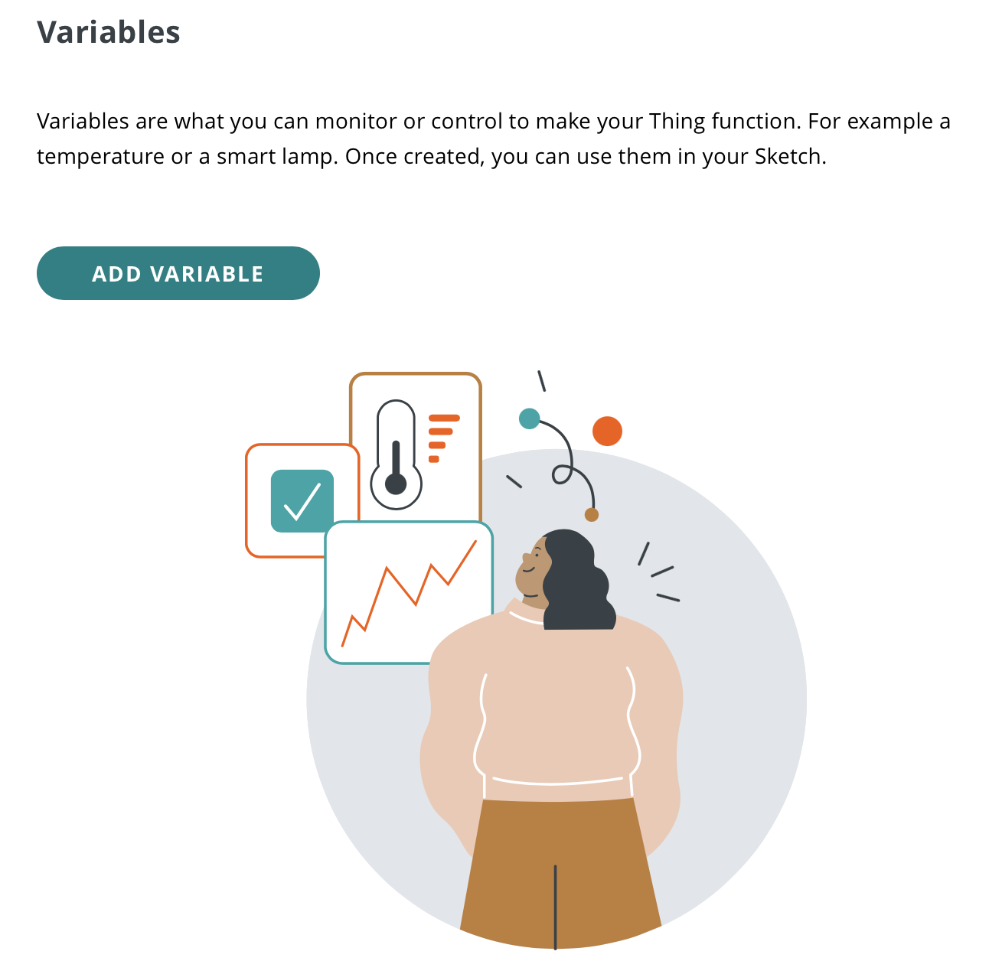
docs/images/variablesarduinocloud.png
