krdarrah/trigBoard_docs/docs/images/waterleakv8_diag.png

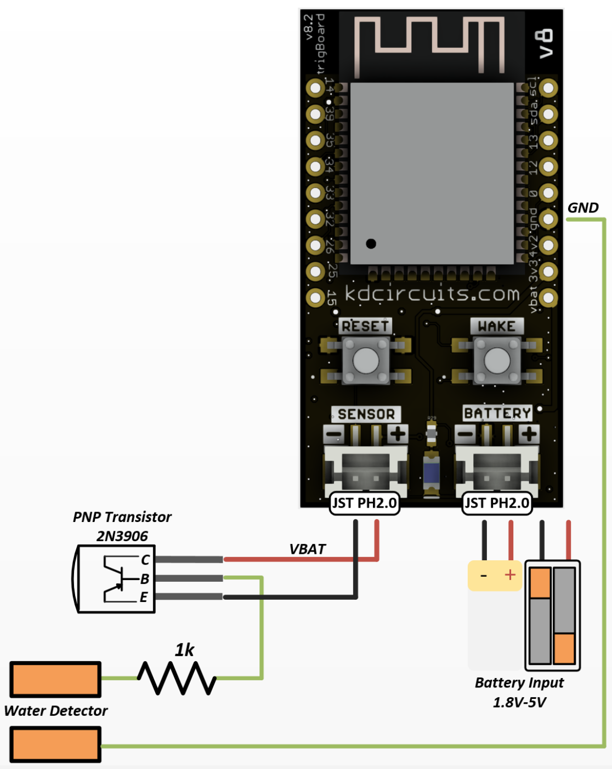
docs/images/waterleakv8_diag.png
