krdarrah/trigBoard_docs/docs/mech/trigEncBase.stl

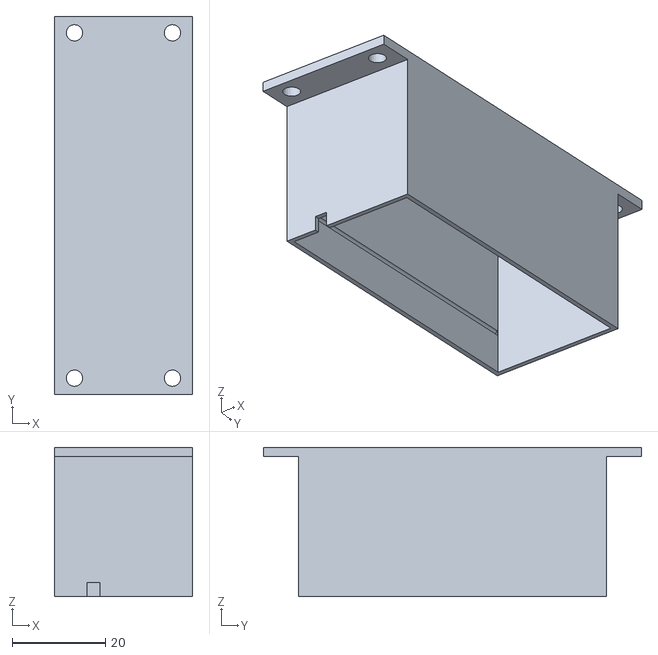
[picture p244: CAD file, 2020-06-19]
docs/mech/trigEncBase.stl
29.6 x 81.0 x 32.0
