krdarrah/trigBoard_docs/docs/mech/trigBoardV8.3.step

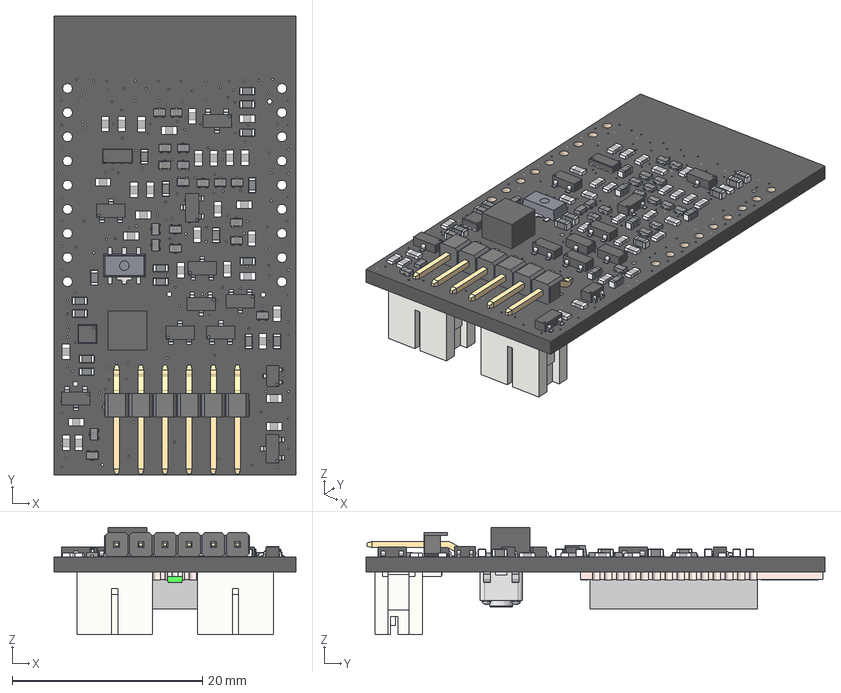
[picture p245: CAD file, 2020-06-19]
docs/mech/trigBoardV8.3.step
25.4 x 48.3 x 11.3 mm
Board
10k x 31
TL3305AF160QG x 2
MMBT2907AWT1G
RV-8263
TPS3839G33DBZR x 2
RZM001P02T2L x 19
DMG2305UX-13
PCB
Module
B2B-PH-SM4-TB(LF)(SN) x 2
M20-88906_MOULD
M20-889_CONTACT x 6
Gehäuse x 17
Kontaktfläche x 34
BAT54 x 7
Board3
Extruded15 x 2
Extruded13 x 2
Board4 x 2
Extruded12 x 2
Board5 x 2
Extruded8
Extruded11
Extruded14 x 2
Extruded9
Extruded10
BLUE
MAX17225ELT+
1X09_NO_SILK x 2
