krdarrah/trigBoard_docs/docs/mech/trigEncLid.stl

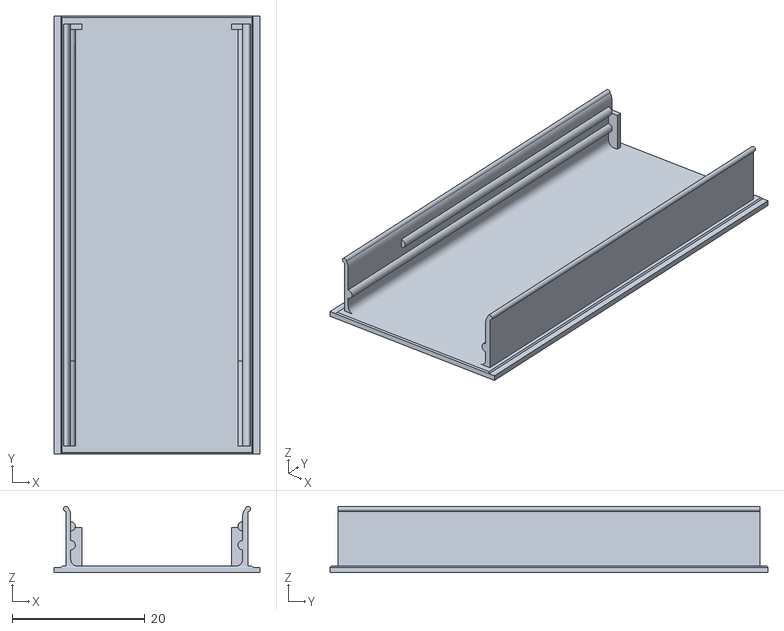
[picture p246: CAD file, 2020-06-19]
docs/mech/trigEncLid.stl
31.0 x 66.0 x 10.0
