krdarrah/trigBoard_docs/docs/images/LMT01_wiring.png

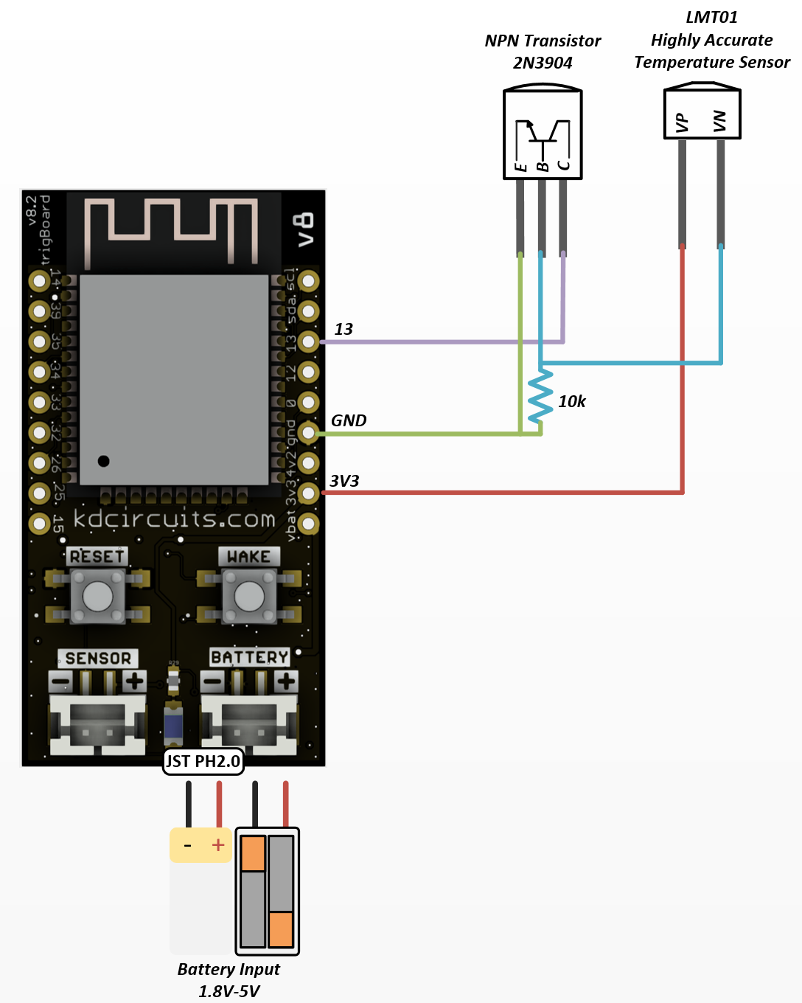
docs/images/LMT01_wiring.png
