krdarrah/trigBoard_docs/docs/images/LMT01_wiringdig12.png

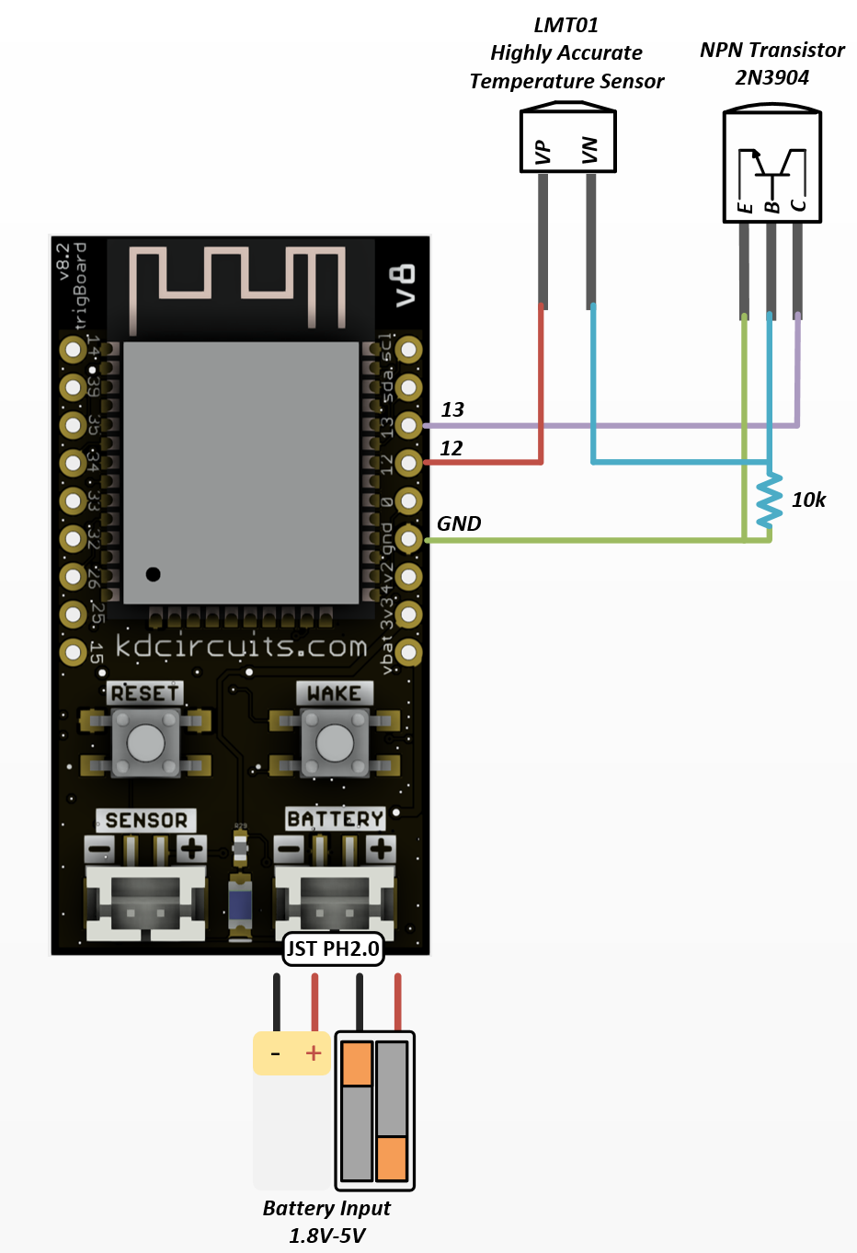
docs/images/LMT01_wiringdig12.png
