krdarrah/trigBoard_docs/docs/images/solderingterminals.png

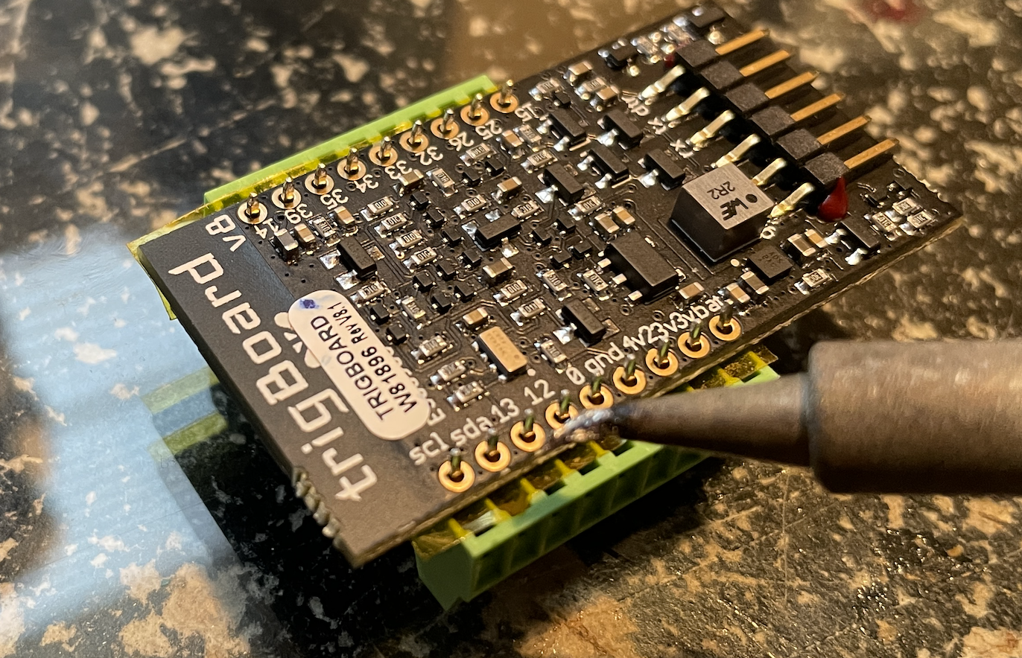
docs/images/solderingterminals.png
