krdarrah/trigBoard_docs/(threads)

Thread 1 (2021-02-21):

Question

mfread, 2021-02-21:

krdarrah, 2021-02-21:
Hi Mark,

Can you email me directly?  I’ll bring you over into the Discord where we can chat

Best Regards,
Kevin Darrah
kevin@kevindarrah.com

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

mfread, 2021-02-21:
Thanks Kevin.

Let me know how to access your discussion board.

Meanwhile, I'm happy to delete my question on GitHub as it's not the place
I should be asking questions :)

Cheers,
Mark

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

krdarrah, 2021-02-21:
yea just send a message to me here and I'll add you to the group where you can discuss with everyone: https://www.kdcircuits.com/#contact

mfread, 2021-02-21:
Question moved to a discussion forum.

Closed 2021-02-21.

Thread 2 (2021-07-02):

Fast battery draining issue

michK, 2021-07-02:
Hi,

Not sure where the official place is to ask questions, but I hope you don't mind me doing it here.

My Trigboard v8 has been working great for many months, but then all of a sudden the battery started draining really quickly.

The last reported voltage (with 2 x AAA cells) was 2.71 volts, and then it was just dead.

After replacing the batteries and manually triggering the board a few times, I notices that every now and then the board gets stuck in 'awake' mode for around 20 seconds before going to sleep, whike drawing around 50 mA. I think it might have been the same thing draining the battery so quickly, have you ever experienced this?

PS: the board triggers in my front door opening, so it does trigger quite a lot and I guess that could also speed up the battery drain, but I still think it should run a bit longer at 2.71 volts.

Thanks!
Mike

Closed 2021-07-04.

Thread 3 (2023-10-11):

Trigboard V4 Pushbullet no longer working

motechsolutions, 2023-10-11:
Hi
I purchased a pair of Trigboard V4 boards some time ago and ive been using one as a mailbox/postbox push alert using pushbullet.

A few weeks ago the pushbullet function stopped working, im assuming pushbullet have changed something on there API

Do you have a updated Trugboard V4 firmware or another  firmware that works with pushbullet or pushsafer

Closed 2023-10-11.
