krdarrah/trigBoard_docs/docs/solarFiles/trigSolarV1.1_SCH.pdf

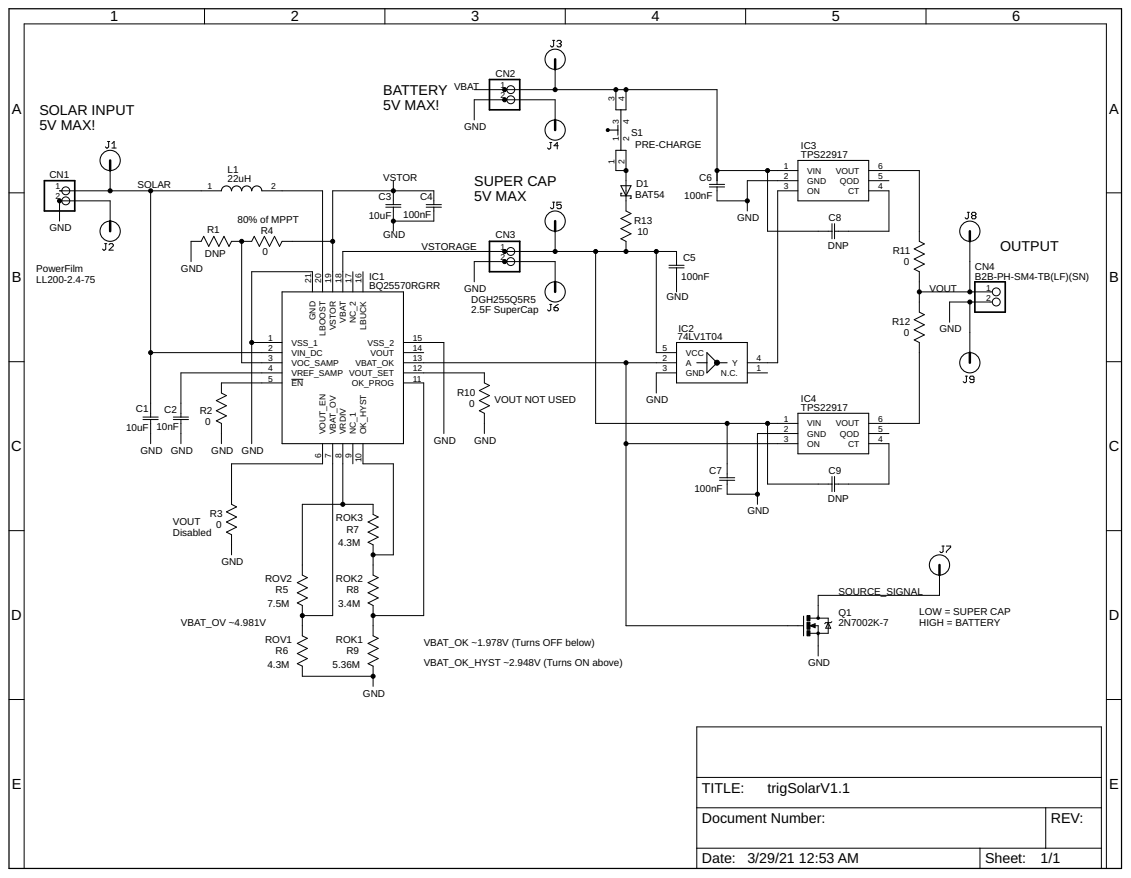
[picture p255: page 1]

Document Number: | REV:

Date: 3/29/21 12:53 AM | Sheet: 1/1
