krdarrah/trigBoard_docs/(commit log)

2020-06-19 even more youtube
    [buildout.cfg]
2020-06-19 mech files
    [trigBoardV8.3.step, trigEncBase.stl, trigEncLid.stl]
2020-07-02 battery updates
2020-07-02 battery files
2020-07-24 Couple things added, and Cellular System
2020-08-04 silent button
2020-08-06 battery offset
2020-08-24 4.2V boost
2020-08-31 quick update about powering at 3.3V
2020-09-07 temperature logger
2020-09-07 temperature changes
2020-09-10 new wiring
2020-09-10 leaving old image there just in case I need it
2020-09-18 switched to power sensor to 3v3
2020-09-18 3v3 sensor now
2020-09-20 updates to circuit and video
2020-09-20 new relay pic
2020-09-28 added new PIR sensor option
2020-09-30 added note about the water sensor
2020-10-04 water and temperature updates
2020-12-28 couple updates for TCP and other randoms
2021-01-03 screw terminals
2021-04-30 added home assistant temperature
2021-05-19 under sensor
2021-05-29 couple changes
2021-06-29 added power outage monitoring
2021-11-24 arduinoIoT cloud
2022-03-09 update for P-CH switch
